levykrak/cwiartka/jpg/IMG_3934.JPG

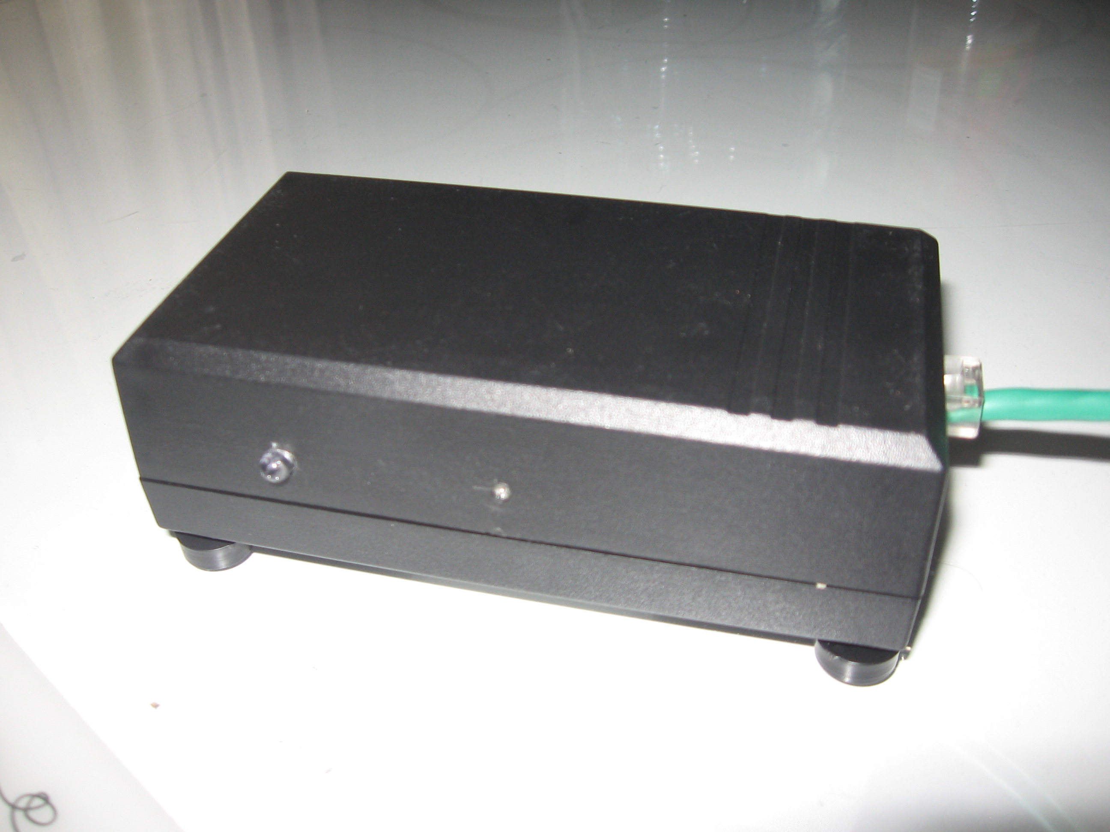
jpg/IMG_3934.JPG
