levykrak/cwiartka/jpg/IMG_3936.JPG

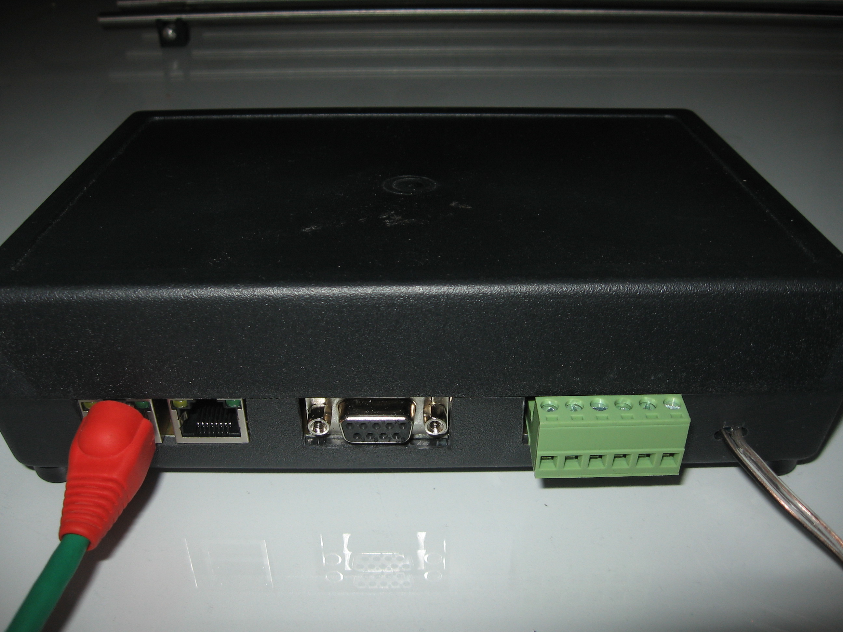
jpg/IMG_3936.JPG
