levykrak/cwiartka/rozne_pliki/25_08.pdf

# Projekty AVT

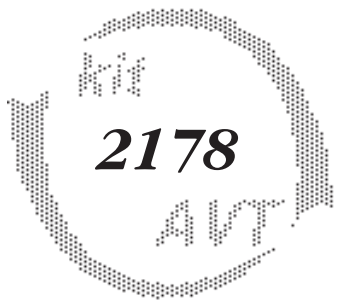
[picture p3: figure]
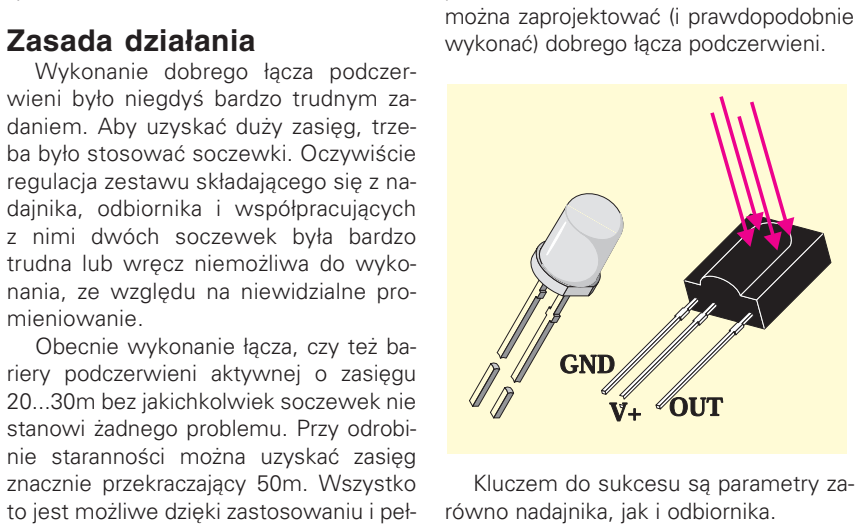
[picture p4: figure]
Zasada działania; Wykonanie dobrego łącza podczer− wieni było niegdyś bardzo trudnym za− daniem. Aby uzyskać duży zasięg, trze− ba było stosować soczewki. Oczywiście; dajnika, odbiornika i współpracujących z nimi dwóch soczewek była bardzo trudna lub wręcz niemożliwa do wyko− nania, ze względu na niewidzialne pro− mieniowanie. Obecnie wykonanie łącza, czy też ba− riery podczerwieni aktywnej o zasięgu 20...30m bez jakichkolwiek soczewek nie stanowi żadnego problemu. Przy odrobi− nie staranności można uzyskać zasięg znacznie przekraczający 50m. Wszystko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

ELEKTRONIKA DLA WSZYSTKICH 1/98 | 11

Nie słabnie zainteresowanie wszel− kiego typu urządzeniami wykorzystują− cymi promieniowanie podczerwone. W EdW przedstawiliśmy już kilka ukła− dów wykorzystujących podczerwień, a listy Czytelników przynaglają nas do przedstawienia kolejnych.
W niniejszym artykule przedstawio− no układ toru podczerwieni dalekiego zasięgu, umożliwiający stworzenie ba− riery o zasięgu 50m i większym. Uwa− ga! Tak duży zasięg uzyskano bez ja− kichkolwiek soczewek czy innych ukła− dów optycznych. Co ciekawe, suma− ryczny pobór prądu przez nadajnik i od− biornik wynosi mniej niż 10mA, z cze− go ponad 90% pobiera nadajnik. Artykuł pokazuje, w jaki sposób można uzyskać bardzo duży zasięg przy minimal− nym poborze prądu. Zawarte w nim wia− domości będą wielką pomocą dla osób chcących samodzielnie zaprojektować podobny układ według własnych potrzeb. Przedstawiany układ przeznaczony jest głównie do celów eksperymental− nych, ale może także znaleźć praktyczne zastosowania. Każdy, kto interesuje się wykorzystaniem promieniowania pod− czerwonego, powinien wykonać oraz praktycznie przebadać opisany dalej pros− ty i tani układ.

regulacja zestawu składającego się z na−

to jest możliwe dzięki zastosowaniu i peł− nym wykorzystaniu parametrów nowo− czesnych podzespołów.
W opisywanym układzie zastosowano dobrze znany scalony odbiornik podczer− wieni TFMS5360 oraz wysokosprawną diodę podczerwoną o wąskim kącie świe− cenia. Ich właściwe wykorzystanie umoż− liwia osiągnięcie wręcz rewelacyjnych pa− rametrów łącza. Jednocześnie każda nie− doróbka mści się dotkliwie i znacznie zmniejsza zasięg. Ponieważ chodzi o „wyduszenie” ze wspomnianych pod− zespołów wszystkich ich możliwości, ko− nieczne jest zapoznanie się z głównymi parametrami. Bez ich zrozumienia nie

W przypadku diody nadawczej podsta− wowe znaczenie mają dwie sprawy:
– kąt świecenia diody
– maksymalny dopuszczalny prąd impul− sowy.
W przypadku odbiornika podstawowe znaczenie ma częstotliwość impulsów oraz długość fali świetlnej.
W tabeli 1 podano podstawowe para−
metry | diod | nadawczych | TSIP5201

# Prosty tor osty tor podczerwieni aktywnej podczerwieni aktywnej dalekiego zasięgu dalekiego zasięgu

Podstawowe parametry diod TSIP520X: Dopuszczalne
napięcie wsteczne: | 7 V
Prąd przewodzenia: | 150 mA
Szczytowy prąd przewodzenia
(tp /T=0,5, tp =100µs): 300 mA Niepowtarzalny prąd przewodzenia
(tp =100µs): | 3 A
Moc strat: | 210 mW
Maksymalna
temperatura złącza: | 100°C
Rezystancja
termiczna Rthja: | 350 K/W
Kąt świecenia: | ±17 stopni
Długość fali
promieniowania: | 925 nm
Czas włączania
i wyłączania: | 500...800 ns
Natężenie promieniowania
(IF =100mA, tp =20ms):
TSIP5200: | 40 mW/sr
TSIP5201: | 50 mW/sr

Tabela 1

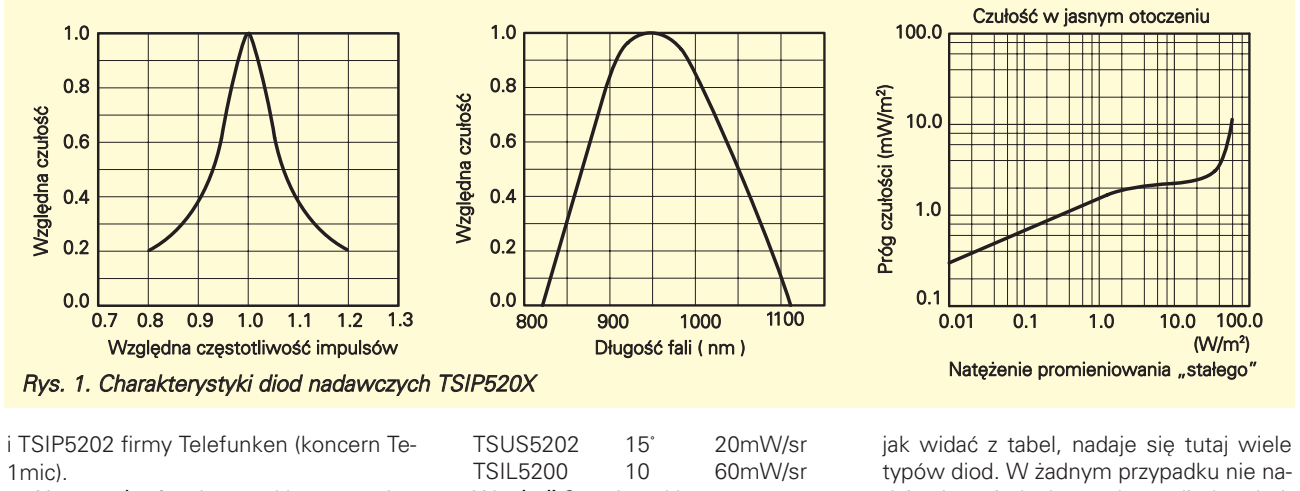
[picture p5: figure]
1mic).; TSUS5202; TSIL5200; typów diod. W żadnym przypadku nie na−

### 12 ELEKTRONIKA DLA WSZYSTKICH 1/98

i TSIP5202 firmy Telefunken (koncern Te−

Na rysunku 1 pokazano kluczowe cha− rakterystyki tych diod. Rysunek 1a poka− zuje charakterystykę promieniowania. Jak widać, światło emitowane jest w po− staci stosunkowo wąskiego stożka. Dzię− ki zmniejszeniu kąta stożka promieniowa− nia uzyskuje się kilku−, a nawet kilkuna− stokrotne zwiększenie natężenia promie− niowania w porównaniu z „klasycznymi” diodami, o kącie świecenia ±25...±40 . Bardzo ważne informacje zawiera rysu− nek 1b. Pokazuje on, że przy zastosowa− niu impulsowej pracy diody, możliwa jest praca przy prądach znacznie większych niż nominalny prąd przewodzenia (który zwyk− le wynosi 100...150mA). Przykładowo przy współczynniku wypełnienia tp/T = 0,01 i czasie impulsu 0,1 milisekundy, wartość prądu podczas impulsu może wynieść 2A! W prezentowanym układzie współczynnik wypełnienia jest jeszcze mniejszy, a czas impulsu – krótszy, można więc pracować przy prądzie o wartości 3A! Nikomu chyba nie trzeba tłumaczyć, że ze wzrostem prą− du rośnie także natężenie promieniowa− nia, a tym samym zasięg łącza. Przykłado− wo w katalogach zazwyczaj podaje się na− tężenie przy prądzie 100mA. Omawiane diody przy prądzie przewodzenia równym 1.5A i czasie impulsu równym 100µs za− pewniają natężenie promieniowania:
TSIP5200: | 240...520 mW/sr
TSIP5201: | 360...650 mW/sr
Rysunek 1c pokazuje zależność napię− cia i prądu przewodzenia – jak widać, przy prądzie 3A spadek napięcia na diodzie wyniesie około 2,5V. Jest to potrzebne do oszacowania wartości rezystora sze− regowego ograniczającego prąd diody. Rysunek 1 pokazuje charakterystyki diod TSIP520X. W ofercie firmy Telefun− ken (Temic) można znaleźć kilka innych diod o zbliżonych parametrach, które również można stosować w opisywanym urządzeniu:
TSUS5200 | 15° | 20mW/sr
(przy 100mA)
TSUS5201 | 15° | 20mW/sr

W tabeli 2 podano kluczowe paramet− ry kilku diod produkowanych przez firmę Siemens.
Również tu najważniejszym paramet− rem jest natężenie promieniowania, wy− rażone w miliwatach na steradian (mW/sr). Warto zauważyć, że duże natę− żenie promieniowania uzyskuje się tylko przy małych kątach świecenia – cała moc skoncentrowana jest wówczas w małym stożku promieniowania. Dla porównania w tabeli zamieszczono dane popularnej diody LD271, która ma znacznie większy kąt rozsyłu światła (±25 ), a tym samym małe natężenie (tylko 10mW/sr).Jak wi− dać z przedstawionych danych, zasięg łą− cza podczerwieni będzie zależeć głównie od kąta promieniowania diody (oraz szczytowej wartości prądu). Aby uzyskać zasięg kilkudziesięciu metrów, w opisy− wanym układzie koniecznie trzeba zasto− sować diodę o jak najwęższym kącie – jak widać z tabel, nadaje się tutaj wiele

dają się tu jednak popularne diody od pi− lotów zdalnego sterowania, ponieważ z reguły mają one szeroki kąt świecenia. Przy zastosowaniu takiej „zwykłej diody od pilota nie ma co liczyć na uzyskanie za− sięgu rzędu 50m.
Drugim kluczowym czynnikiem jest zastosowanie dobrego odbiornika. Aby maksymalnie uprościć konstrukcję zasto− sowano typowy scalony odbiornik pod− czerwieni TFMS5360. Czytelnicy EdW sporo już o tym układzie wiedzą. Układ TFMS5360 zawiera w sobie fotodiodę, wzmacniacz, filtr i inne obwody, dzięki którym nie reaguje na przypadkowe syg− nały podczerwieni, a tylko na przebiegi o określonej częstotliwości. Dwie środ− kowe cyfry oznaczenia podają tę częstot− liwość (w kilohercach) – układ TFMS5360 reaguje jedynie na impulsy promieniowa− nia podczerwonego o częstotliwości po− wtarzania 36kHz. Rysunek 2a pokazuje,

Rys. 1. Charakterystyki diod nadawczych TSIP520X

Typ | Kąt [°] | mW/sr | µs | nm | Obudowa
LD271L | 25 | 10,00 | 1,0 | 950 | 5−mm−LED
LD274 | 10 | 50,00 | 1,0 | 950 | 5−mm−LED
LD274−2 | 10 | 50,00 | 1,0 | 950 | 5−mm−LED
LD274−3 | 10 | 80,00 | 1,0 | 950 | 5−mm−LED
SFH400 | 6 | 20,00 | 1,0 | 950 | TO−18
SFH400−2 | 6 | 20,00 | 1,0 | 950 | TO−18
SFH400−3 | 6 | 32,00 | 1,0 | 950 | TO−18
SFH400−4 | 6 | 50,00 | 1,0 | 950 | TO−18
SFH401 | 15 | 16,00 | 1,0 | 950 | TO−18
SFH401−3 | 15 | 16,00 | 1,0 | 950 | TO−18
SFH401−4 | 15 | 25,00 | 1,0 | 950 | TO−18
SFH415 | 17 | 16,00 | 0,5 | 950 | 5−mm−LED
SFH415−T | 17 | 25,00 | 0,5 | 950 | 5−mm−LED
SFH415−U | 17 | 40,00 | 0,5 | 950 | 5−mm−LED
SFH416−R | 28 | 10,00 | 0,5 | 950 | 5−mm−LED
SFH480−2 | 6 | 40,00 | 0,6 | 880 | TO−18
SFH480−3 | 6 | 63,00 | 0,6 | 880 | TO−18
SFH481 | 15 | | “” | 880 | TO−18
SFH481−1 | 15 | 10,00 | 0,6 | 880 | TO−18
SFH481−2 | 15 | 16,00 | 0,6 | 880 | TO−18
SFH481−3 | 15 | 25,00 | 0,6 | 880 | TO−18
SFH484 | 8 | 50,00 | 0,6 | 880 | 5−mm−LED
SFH484−1 | 8 | 50,00 | 0,6 | 880 | 5−mm−LED

Tabela 2

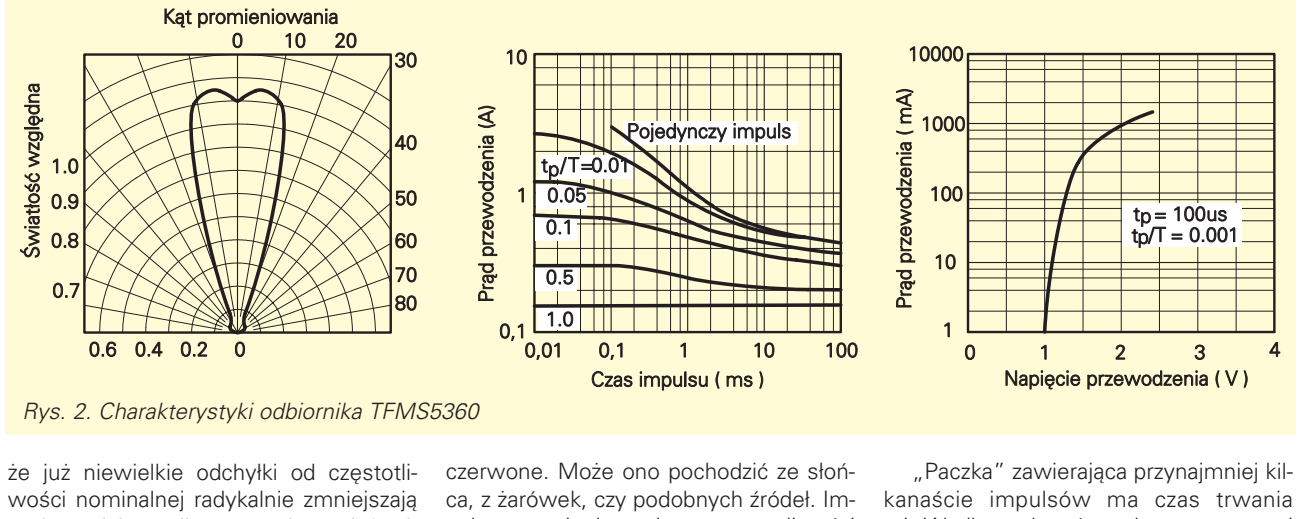
[picture p6: figure]
wości nominalnej radykalnie zmniejszają; czerwone. Może ono pochodzić ze słoń−; „Paczka” zawierająca przynajmniej kil− kanaście impulsów ma czas trwania; Rys. 2. Charakterystyki odbiornika TFMS5360

że już niewielkie odchyłki od częstotli−

czułość. Jak wynika z rysunku 2a już od− chyłka o 10% od częstotliwości środko− wej daje ponad dwukrotne zmniejszenie czułości. Do tego dochodzi jeszcze nie− unikniona tolerancja związana z rozrzuta− mi produkcyjnymi – należy liczyć się z od− chyłkami częstotliwości środkowej rzędu do 5%. Biorąc to pod uwagę, należy za− pewnić właściwą, stabilną częstotliwość impulsów wysyłanych z nadajnika. O czu− łości i stabilności parametrów decydo− wać więc będzie stabilność częstotliwoś− ci generatora impulsów 36kHz w nadajni− ku.
Drugą sprawą, którą należy wziąć pod uwagę jest długość fali promieniowania. Niektóre diody (np. LD274) promieniują

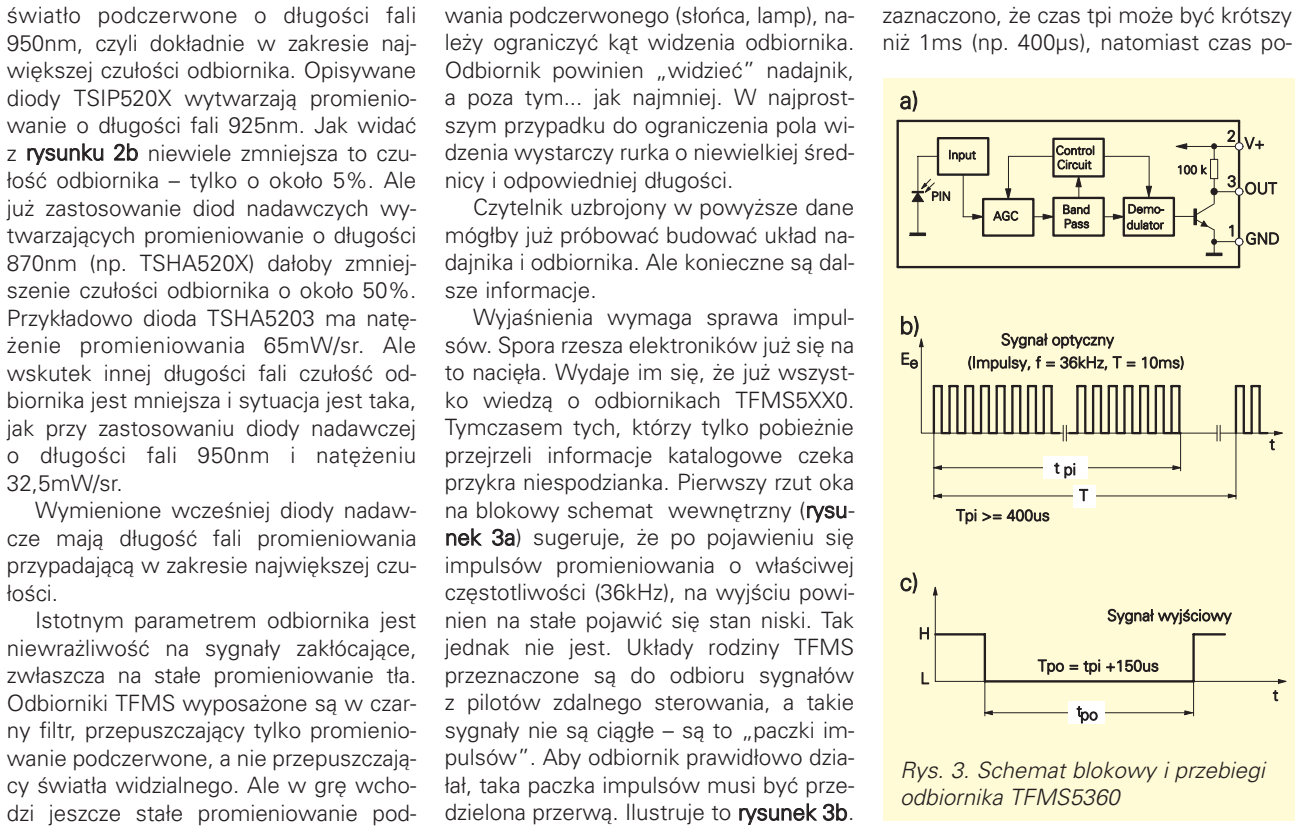
[picture p7: figure]
światło podczerwone o długości fali 950nm, czyli dokładnie w zakresie naj− większej czułości odbiornika. Opisywane diody TSIP520X wytwarzają promienio− wanie o długości fali 925nm. Jak widać z rysunku 2b niewiele zmniejsza to czu− łość odbiornika – tylko o około 5%. Ale już zastosowanie diod nadawczych wy− twarzających promieniowanie o długości 870nm (np. TSHA520X) dałoby zmniej− szenie czułości odbiornika o około 50%. Przykładowo dioda TSHA5203 ma natę− żenie promieniowania 65mW/sr. Ale wskutek innej długości fali czułość od−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

biornika jest mniejsza i sytuacja jest taka, ca, z żarówek, czy podobnych źródeł. Im− pulsy promieniowania o częstotliwości 36kHz są więc prawie zawsze nałożone na stałe promieniowanie tła. Rysunek 2c pokazuje, jak zmienia się czułość na im− pulsy w zależności od tego stałego pro− mieniowania tła. Jak widać czułość znacznie się zmniejsza przy wzroście te− go stałego promieniowania. Na rysunku 2 nie pokazano charakterystyki czułości kątowej (przestrzennej) odbiornika. Wy− starczy wiedzieć, że odbiornik „patrzy” bardzo szeroko, mniej więcej ±55 od osi (obszar największej czułości zaznaczony jest fioletowymi strzałkami na rysunku wstępnym).
Jeśli tak, to aby zapobiec utracie czu− łości pod wpływem „obcego” promienio−

dzenia wystarczy rurka o niewielkiej śred−

dajnika i odbiornika. Ale konieczne są dal−

sów. Spora rzesza elektroników już się na to nacięła. Wydaje im się, że już wszyst−

nien na stałe pojawić się stan niski. Tak

sygnały nie są ciągłe – są to „paczki im−

łał, taka paczka impulsów musi być prze− dzielona przerwą. Ilustruje to rysunek 3b.

tpi. Według zaleceń producenta czas tpi nie powinien być krótszy niż 400µs. Bio− rąc pod uwagę, że impulsy o częstotli− wości 36kHz mają okres równy 27,7µs, w każdej paczce nie powinno być mniej niż 15 impulsów. Jeśli będzie ich mniej, to układ może nieprawidłowo reagować na pobudzenie. A jeśli będzie ich więcej? To akurat nic nie przeszkadza, pod warun− kiem, że czas trwania paczki impulsów tpi jest krótszy od czasu przerwy. Ściślej biorąc, dla prawidłowej pracy odbiornika czas powtarzania, oznaczony na rysunku 3b literą T, powinien być przynajmniej 2,5 raza dłuższy niż czas tpi.
W praktyce czas przerwy może być, i często jest, bardzo długi. Na rysunku 3b zaznaczono, że czas tpi może być krótszy
ELEKTRONIKA DLA WSZYSTKICH 1/98 | 13

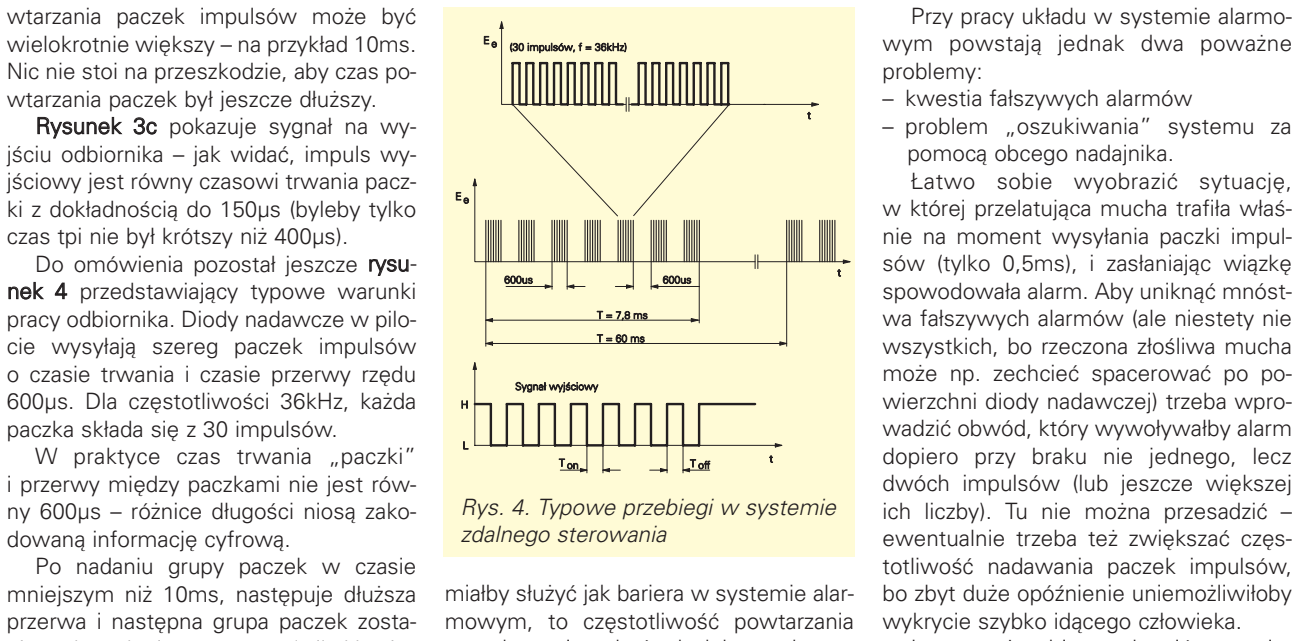
[picture p8: figure]
wtarzania paczek impulsów może być; wtarzania paczek był jeszcze dłuższy. Rysunek 3c pokazuje sygnał na wy−; czas tpi nie był krótszy niż 400µs). Do omówienia pozostał jeszcze rysu− nek 4 przedstawiający typowe warunki; cie wysyłają szereg paczek impulsów o czasie trwania i czasie przerwy rzędu 600µs. Dla częstotliwości 36kHz, każda paczka składa się z 30 impulsów. W praktyce czas trwania „paczki” i przerwy między paczkami nie jest rów− ny 600µs – różnice długości niosą zako− dowaną informację cyfrową. Po nadaniu grupy paczek w czasie mniejszym niż 10ms, następuje dłuższa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

wielokrotnie większy – na przykład 10ms. Nic nie stoi na przeszkodzie, aby czas po−

jściu odbiornika – jak widać, impuls wy− jściowy jest równy czasowi trwania pacz− ki z dokładnością do 150µs (byleby tylko

pracy odbiornika. Diody nadawcze w pilo−

przerwa i następna grupa paczek zosta− nie nadana dopiero po 60ms (o ile klawisz w pilocie jest ciągle naciśnięty).
Tak mniej więcej pracuje pilot, a na wyjściu odbiornika TFMS występuje przebieg podobny, jak pokazano na dole rysunku 4. Czasy Ton i Toff odpowiadają czasowi trwania paczki impulsów oraz przerwy między paczkami.
Tak pracuje typowy system zdalnego sterowania z pilotem.
Natomiast opisywany tor podczerwie− ni pracuje w trochę innym rytmie. Tu rów− nież nadajnik wysyła paczki impulsów za− wierające około 18 impulsów o częstotli− wości 36kHz (co daje czas trwania paczki równą 500µs). Tym razem czas powtarza−

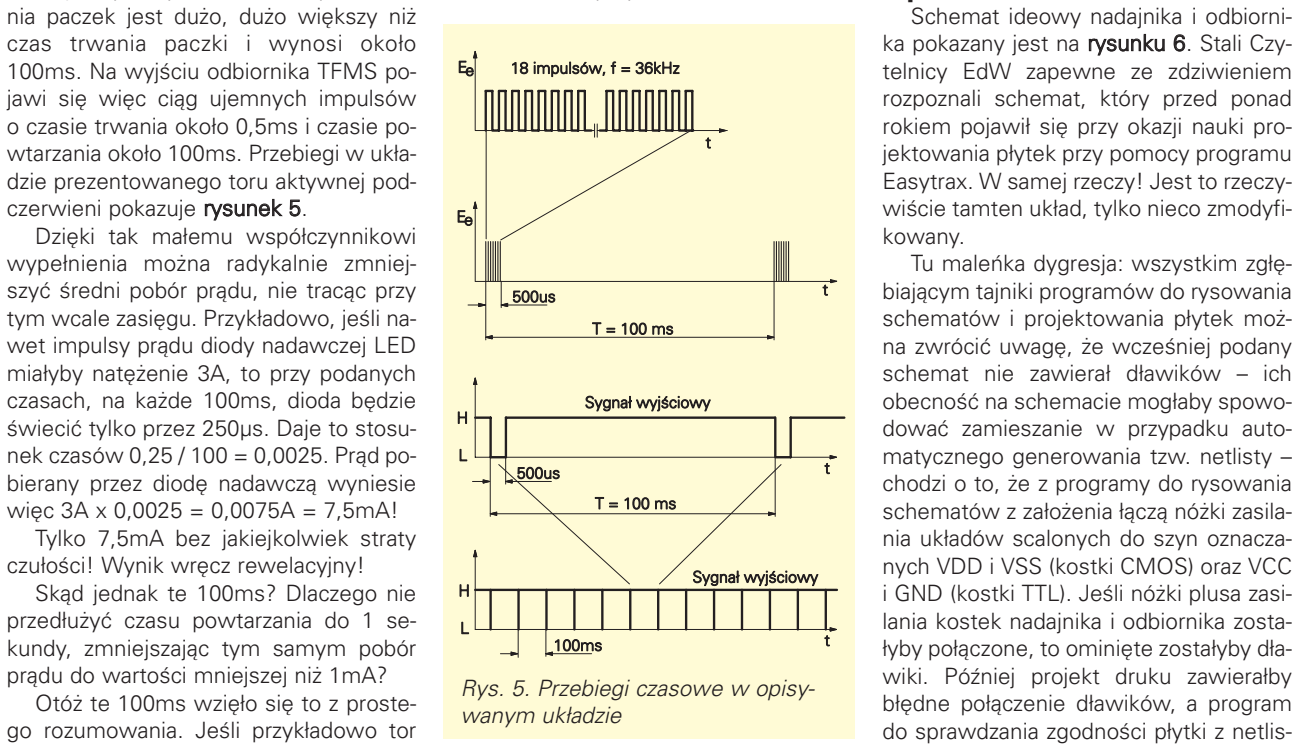
[picture p9: figure]
czas trwania paczki i wynosi około 100ms. Na wyjściu odbiornika TFMS po− jawi się więc ciąg ujemnych impulsów; dzie prezentowanego toru aktywnej pod− czerwieni pokazuje rysunek 5. Dzięki tak małemu współczynnikowi wypełnienia można radykalnie zmniej−; wet impulsy prądu diody nadawczej LED miałyby natężenie 3A, to przy podanych czasach, na każde 100ms, dioda będzie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

nia paczek jest dużo, dużo większy niż

o czasie trwania około 0,5ms i czasie po− wtarzania około 100ms. Przebiegi w ukła−

szyć średni pobór prądu, nie tracąc przy tym wcale zasięgu. Przykładowo, jeśli na−

świecić tylko przez 250µs. Daje to stosu− nek czasów 0,25 / 100 = 0,0025. Prąd po− miałby służyć jak bariera w systemie alar−

paczek powinna być tak dobrana, by na− wet szybko idący człowiek przeciął ją na czas w którym pojawi się przynajmniej dwie paczki. Te dwie paczki nie zostaną odebrane przez odbiornik i zostanie wy− wołany alarm. Jeśli czas miedzy kolejny− mi paczkami byłby zbyt długi, wtedy prze− chodzący człowiek po prostu nie zostałby zauważony – najprawdopodobniej prze− szedłby w przerwie między paczkami. Wartość 100ms wydaje się tu wystar− czająca – oczywiście w przypadku stoso− wania urządzenia w systemie alarmo− wym częstotliwość powtarzania paczek można zwiększyć z podanych 10Hz (100ms) do na przykład 25Hz (40ms).

w której przelatująca mucha trafiła właś−

Łatwo też sobie wyobrazić sytuację, w której przemyślny włamywacz unie− szkodliwi tor podczerwieni, świecąc za pomocą dowolnego pilota w odbiornik. Jeśli układ miałby kiedykolwiek praco− wać w systemie alarmowym, powinien zawierać obwody, które chroniłyby przed takim sabotażem i wywoływały alarm w przypadku wykrycia „obcej” sekwencji paczek impulsów. Sposobów realizacji obu wyżej podanych postula− tów jest mnóstwo. W prezentowanym układzie zrealizowano je w bardzo pros− ty sposób.

## Opis układu

ka pokazany jest na rysunku 6. Stali Czy−

rokiem pojawił się przy okazji nauki pro−

Easytrax. W samej rzeczy! Jest to rzeczy− wiście tamten układ, tylko nieco zmodyfi−

schematów z założenia łączą nóżki zasila−

i GND (kostki TTL). Jeśli nóżki plusa zasi− lania kostek nadajnika i odbiornika zosta− łyby połączone, to ominięte zostałyby dła−

do sprawdzania zgodności płytki z netlis−

### 14 ELEKTRONIKA DLA WSZYSTKICH 1/98

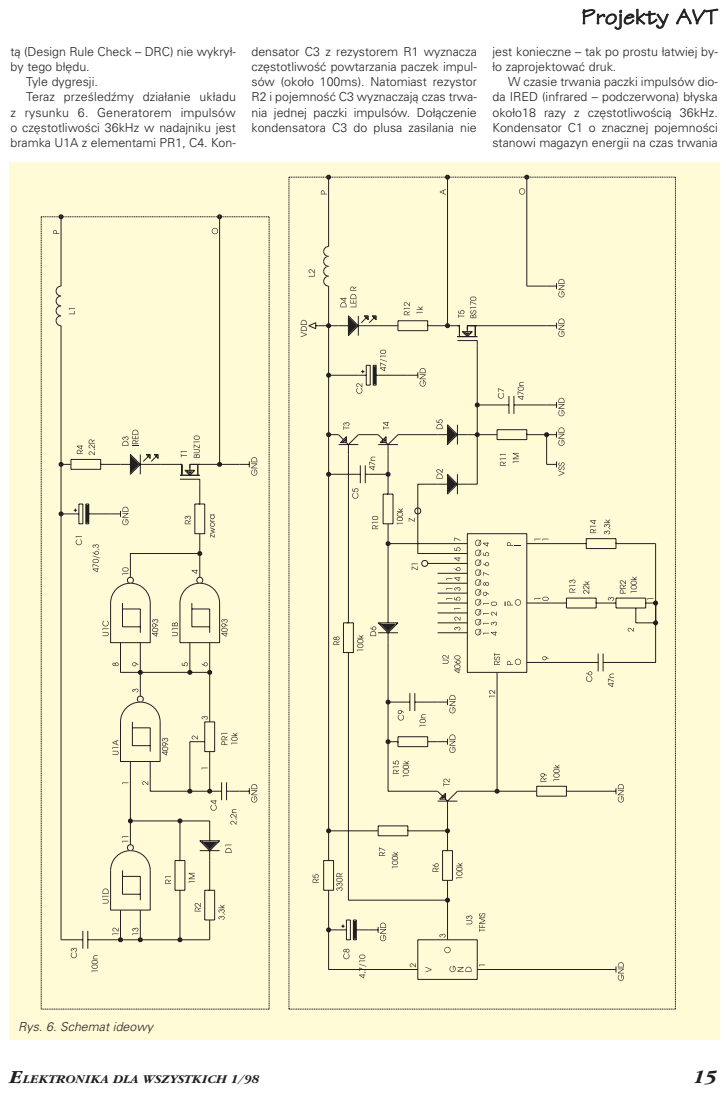
[picture p10: page 5]
ELEKTRONIKA DLA WSZYSTKICH 1/98

tą (Design Rule Check – DRC) nie wykrył−
by tego błędu.
Tyle dygresji.
Teraz prześledźmy działanie układu
z rysunku 6. Generatorem impulsów
o częstotliwości 36kHz w nadajniku jest
bramka U1A z elementami PR1, C4. Kon−

densator C3 z rezystorem R1 wyznacza
częstotliwość powtarzania paczek impul−
sów (około 100ms). Natomiast rezystor
R2 i pojemność C3 wyznaczają czas trwa−
nia jednej paczki impulsów. Dołączenie
kondensatora C3 do plusa zasilania nie

jest konieczne – tak po prostu łatwiej by−
ło zaprojektować druk.
W czasie trwania paczki impulsów dio−
da IRED (infrared – podczerwona) błyska
około18 razy z częstotliwością 36kHz.
Kondensator C1 o znacznej pojemności
stanowi magazyn energii na czas trwania

Rys. 6. Schemat ideowy

### 16 ELEKTRONIKA DLA WSZYSTKICH 1/98

paczki impulsów. Rezystor R4 o bardzo małej wartości pozwala w czasie trwania impulsu na przepływ prądu o dużej war− tości (przy napięciu zasilania 9V około 3A). Właśnie ze względu na tak dużą war− tość prądu zastosowano tranzystor mocy MOSFET. Małe MOSFETy takie jak BS107 czy BS170 maja rezystancję w stanie otwarcia rzędu kilku omów lub więcej i nie nadają się do tego zastoso− wania. W obwodzie bramki tranzystora T1 przewidziano rezystor R3. Przy wyko− rzystaniu tranzystora MOSFET jest on za− stąpiony zworą, ale w roli T1 może też pracować „darlington” npn większej mo− cy i wtedy rezystor będzie potrzebny do ograniczenia prądu bazy. W przypadku stosowania „darlingtona” należy się upewnić, czy jest on dostatecznie szybki. Dużą ostrożność trzeba wykazać przy próbie zastosowania w roli T1 zwykłego tranzystora npn. Przy jego niewielkim wzmocnieniu może się okazać, że bram− ki U1C i U1D nie są w stanie dostarczyć odpowiedniego prądu bazy. W każdym przypadku stosowania tranzystorów in− nych niż MOSFET, należy sprawdzić os− cyloskopem przebieg na kolektorze tran− zystora (na katodzie diody D3).

Przy tak dużych impulsach prądu ko− nieczne są obwody filtrujące – dławiki L1 i L2 oraz kondensatory C1 i C2. Czułość układu odbiorczego jest bardzo duża i bez dławików niemożliwe byłoby zasilanie na− dajnika i odbiornika z tego samego źród− ła, bo impulsy przechodzące z nadajnika do odbiornika przez linie zasilania zakłóca− łyby pracę układu U3.
Układ odbiornika wygląda dość zawile. Jego działanie nie jest jednak trudne do zrozumienia.
Pomocą w analizie będą rysun− ki 7 oraz 8.
Przede wszystkim trzeba wiedzieć, że w prawidłowo działającym torze, każda odebrana paczka impulsów wytwarza na wyjściu kostki TFMS krótki impuls ujem− ny (0,5ms), który z kolei powoduje wyze− rowanie licznika U1 (CMOS 4060). Od tej chwili określenie „impuls” będzie ozna− czać ten właśnie impuls elektryczny o dł− ugości 0,5ms, który pojawia się na wy− jściu odbiornika U3 (TFMS5360) po ode− braniu paczki impulsów świetlnych.
Po każdym takim impulsie licznik U2 zaczyna swą pracę od nowa. Na rysun− ku 7 pokazano niektóre przebiegi na jego wyjściach. Bardzo ważną rolę pełni syg− nał z wyjścia Q4 (nóżka 7 układu U2) – przebieg z rysunku 7b.
Na rysunku 7 pokazano, że licznik U2 rozpoczął cykl pracy po kolejnym impul− sie zerującym. Moment przyjścia tego impulsu zerującego zaznaczono pionową niebieską linią. Przebieg na wyjściu Q4 decyduje, co stanie się po przyjściu na− stępnego impulsu. Jeśli następny impuls z odbiornika TFMS pojawi się w czasie, gdy na wyjściu Q4 wystąpi stan wysoki (zaznaczono to zielonym kolorem na prze− biegu 7b), wtedy licznik zostanie prawid− łowo wyzerowany i cykl pracy rozpocznie się od nowa. Zerowanie licznika umożliwi podanie stanu wysokiego przez diodę D6 na kondensator C9 – dopiero wtedy tran− zystor T2 będzie mógł pewnie wyzero− wać kostkę przez jej wejście RST (nóżka 12). Obwód D6, R15 i C9 jest potrzebny do przedłużenia czasu trwania stanu wy− sokiego z wyjścia Q4. Należy pamiętać, że w chwili zerowania, na wyjściu Q4 po− jawia się stan niski. Bez obwodu D6, R15 i C9 impuls zerujący na wejściu RST był− by więc bardzo krótki (kilkadziesiąt nano− sekund), co w pewnych warunkach unie− możliwiłoby pełne zerowanie wszystkich stopni licznika. Wspomniany obwód po− zwala przedłużyć impuls zerujący kostkę U2 i pewnie ją wyzerować.
Wskutek tego ustawicznego zerowa− nia, w czasie normalnej pracy, przebieg na wyjściu Q4 będzie wyglądał jak na dol− nym rysunku – 7d, gdzie zaznaczono go kolorem zielonym. W tym miejscu należy zauważyć, że w czasie normalnej pracy, przebieg na wyjściu Q4 będzie miał wy− pełnienie różne od 50%. Częstotliwość oscylatora kostki U2 należy ustawić za pomocą potencjometru PR2 w ten spo− sób, by w czasie normalnej pracy dodat− nie impulsy występujące na wyjściu Q4 były dwukrotnie krótsze od czasu prze− rwy. Jak wynika z rysunku 7b, czas prze− rwy na wyjściu Q4 powinien trwać 66,6ms, co zostanie spełnione, jeśli okres drgań oscylatora będzie ustawiony za po− mocą PR2 na 133,2ms / 16 = 8,325ms, co odpowiada częstotliwości 120Hz. Przy takiej częstotliwości oscylatora uzyska się optymalny przebieg na wyjściu Q4. Z rysunku 7b jasno wynika, że zapewni to
znaczny | margines | bezpieczeństwa
w przypadku, gdyby częstotliwość gene− ratora taktującego w nadajniku (o okresie 100ms) zmieniła się o kilka czy kilkana− ście procent.
Właśnie, żeby uzyskać optymalny margines bezpieczeństwa, trzeba tak ustawić potencjometr PR2, aby następny impuls zerujący przychodził dokładnie tak jak pokazano na rysunku 7b. Wtedy właś− nie na wyjściu Q4 uzyska się przebieg o wypełnieniu 1/3, jak pokazuje to rysu− nek 7d. Rys. 7. Przebiegi czasowe w wersji podstawowej odbiornika

ELEKTRONIKA DLA WSZYSTKICH 1/98 | 17

Aby zabezpieczyć układ przed „obcy− mi” impulsami o innej częstotliwości po− wtarzania, dodano układy wywołujące alarm w przypadku, gdy następny impuls zerujący przyjdzie za wcześnie lub za póź− no. Jeśli następny impuls z odbiornika U3 pojawi się za wcześnie, to znaczy jeszcze podczas trwania stanu niskiego na wy− jściu Q4 (zaznaczonym czerwono na ry− sunku 7b), wtedy alarm zostanie wywoła− ny przez przewodzące tranzystory T3 i T4. Spowoduje to naładowanie konden− satora C7, otwarcie tranzystora T5 i za− świecenie czerwonej diody LED D4. Jeśli z kolei impuls zerujący nie przy− jdzie do czasu pojawienia się stanu wyso− kiego na wyjściu Q5 (porównaj rysunek 7c), wtedy alarm zostanie wywołany przez wyjście Q5 i diodę D2.
Jak z tego widać w stanie alarmu prze− wodzi tranzystor T5 (co można wykorzys− tać do współpracy z innymi urządzeniami) i świeci dioda D5 (co znakomicie przyda− je się podczas prób i regulacji).
Gdy wszystko jest w porządku, tran− zystor T5 jest zatkany. Układ pobiera nie− wielki prąd rzędu 1mA.
W tym miejscu parę słów na temat za− silania.
Ze względu na obecność układu TFMS, odbiornik musi być zasilany napię− ciem w zakresie 4,5...6V!
Natomiast nadajnik może być również zasilany napięciem rzędu 5...6V, jednak został przewidziany do zasilania napię− ciem 9V (dopuszczalne jest zasilanie na− pięciem 12V, co zwiększy prąd impulsów diody LED nieco powyżej katalogowych wartości).
Taki sposób zasilania wybrano, ponie− waż układ przeznaczony jest przede wszystkim do prób i eksperymentów, a mniej do praktycznych zastosowań. Jeśli ktoś będzie chciał uzyskać zasięg rzędu kilkudziesięciu metrów, i tak zasto− suje oddzielne źródło zasilania nadajnika, choćby w postaci bateryjki 9−woltowej lub akumulatorka 12V, w miejsce długie− go kabla.
Dlaczego układ nie jest zalecany do pracy w systemach alarmowych na wol− nym powietrzu?
Należy wziąć pod uwagę, że w tak prostym i tanim układzie nie uda się uzys− kać parametrów gwarantujących nieza− wodną pracę w każdych warunkach. Cho− dzi tu głównie o zmiany temperatury i na− pięcia zasilania nadajnika. Proste układy generatorów z bramkami U1D i U1A mo− gą nie zapewnić wystarczającej stabilnoś− ci przy zmianach temperatury otoczenia od −20...+30 C, a przynajmniej na takie temperatury narażony jest układ pracują− cy na wolnym powietrzu. Ponadto częs− totliwość wspomnianych generatorów znacznie zależy od napięcia zasilającego i dla długotrwałej niezawodnej pracy nale− ży stosować stabilizację napięcia zasilają− cego nadajnik.
Nie umniejsza to w żadnym stopniu zalet prezentowanego układu. Z jego po− mocą można uzyskać naprawdę rewela− cyjny zasięg bariery.
Teraz kolejna sprawa.
Opisany powyżej sposób pracy wywo− ła alarm już przy braku jednego jedynego impulsu świetlnego. Jak wspomniano, dla zapobieżenia fałszywym alarmom, wywoływanym choćby przez przelatują− ce muchy, układ powinien wywoływać alarm dopiero przy braku nie jednego, tyl− ko dwóch impulsów świetlnych.
Można to zrealizować w bardzo prosty sposób, łącząc anodę diody D2 nie do wyjścia Q5, tylko Q6 (nóżka 4). W tym celu trzeba przeciąć istniejące połączenie i połączyć punkty oznaczone Z, Z1. Przebiegi w układzie będą wyglądać jak na rysunku 8. Tym razem, ponieważ dopuszczalne jest „zaginięcie” jednego impulsu, częstotliwość oscylatora kostki U2 należy ustawić nieco mniejszą, tak by czas przerwy wynosił 60ms (częstotli− wość oscylatora około 133Hz). Przy takim ustawieniu następny prawidłowy impuls, pojawiający się po kolejnych 100 milise− kundach wypadnie mniej więcej na po− czątku kolejnego impulsu na wyjściu Q4 – pokazuje to rysunek 8b.
Podobnie, jak poprzednio, jeśli impuls zerujący nie nadejdzie do czasu pojawie− nia się stanu wysokiego na wyjściu Q6, zostanie wywołany alarm (przez diodę D2).
Przy prawidłowej pracy tej wersji, na wyjściu Q4 powinny występować impul− sy o współczynniku wypełnienia, nie jak poprzednio 1/3 (33%), tylko 2/5 (40%). Oczywiście, można anodę diody D2 dołączyć do wyjścia Q7, i wtedy układ nie zareaguje nawet przy „zagubieniu” trzech kolejnych impulsów świetlnych. W takim wypadku trzeba jeszcze nieco zwiększyć częstotliwość oscylatora kost− ki U2, a podczas normalnej pracy prze− bieg na wyjściu Q4 będzie miał większe wypełnienie, zbliżone do 45%.
Jak widać z tego opisu, działanie ukła− du jest w sumie bardzo proste. Okazuje się jednak, że do uruchomienia i wyregu− lowania układu nie wystarczy miernik uni− wersalny, potrzebny będzie oscyloskop. Właśnie ze względu na konieczność sta− rannego wyregulowania, stopień trud− ności projektu oceniono na dwie gwiazd− ki.
W zasadzie, na podstawie podanych dalej wskazówek można wyregulować układ korzystając tylko z miernika (współ−

Rys. 8. Przebiegi czasowe w zmodyfikowanej wersji odbiornika czynnik wypełnienia impulsów można określić jako stosunek uśrednionego na− pięcia stałego do napięcia zasilającego, dołączając miernik przez obwód całkujący RC o dużej stałej czasowej). Jednak w przypadku jakichkolwiek kłopotów czy wątpliwości nie obędzie się bez pomocy oscyloskopu.

## Montaż i uruchomienie

Układ można zmontować na dwóch maleńkich płytkach drukowanych pokaza− nych na rysunku 9. Montaż nie sprawi większych kłopotów, a dodatkową pomo− cą będą fotografie modelu. Płytki zostały przewidziane do umieszczenia w odcin− kach rurki instalacyjnej o średnicy we− wnętrznej 23mm, używanej przez elekt− ryków.
Warto wcześniej przygotować te rurki i podczas montażu sprawdzać, czy układ zmieści się wewnątrz niej. Szczególną uwagę trzeba zwrócić na kondensator C1 w nadajniku, który prawdopodobnie trze− ba będzie zmontować poziomo. Odbior− nik TFMS można wlutować wprost w płytkę, ale w modelu nie obcinano jego nóżek, tylko wygięto je w łuk i przyluto− wano od strony druku.
Na początek, można nie montować w nadajniku rezystora R4, a zamiast nie− go wlutować rezystor o wartości 68...150Ω. Zabezpieczy to diodę nadaw− czą w przypadku błędów w działaniu na− dajnika.
Montaż nie sprawi kłopotów, nie ma tu nic szczególnie trudnego.
Po zmontowaniu nadajnika i odbiorni− ka całość trzeba wyregulować. Potencjometrem PR1 należy ustawić częstotliwość powtarzania impulsów równą 36kHz. Posiadacze zwykłych, prostych oscyloskopów mogą mieć kło−
poty | z | zaobserwowaniem | krótkich
„paczek impulsów” o częstotliwości 36kHz, trwających tylko około 500µs. Na czas ustawiania częstotliwości generato− ra U1A można zewrzeć wejścia bramki U1D do masy, ale lepiej jest w miejsce rezystora R2 o wartości 3,3kΩ, dać rezys− tor o wartości 220kΩ...1MΩ. Oczywiście do takich eksperymentów rezystor R4 musi mieć wartość rzędu co najmniej 100Ω, bo przy wartości 2,2Ω dioda na− dawcza w krótkim czasie ulegnie uszko− dzy granicami zanikania impulsów na wy− jściu U3. Znalezienie właściwej pozycji potencjometry PR1 będzie jeszcze łat− wiejsze, jeśli rezystor R4 zostanie jeszcze bardziej zwiększony – nawet do kilku kilo− omów. Czułość odbiornika jest bardzo du− ża i przy próbach na stole wystarczy bar− dzo mały prąd diody nadawczej. Pozwoli to dokładniej dostroić nadajnik do częs− totliwości filtru odbiornika TFMS.
Po ustawieniu właściwej częstotliwoś− ci generatora U1A, należy skontrolować z grubsza czas trwania „paczki impul− sów” (ustala ją rezystor R2) i przerwy między paczkami (odpowiada za nią R1). Trzeba obejrzeć przebieg na nóżkach 1 i 11 kostki U1. Jeśli czasy te różnią się nie więcej niż o 20...50% od wcześniej podanych 0,5ms i 100ms, nie trzeba ni− czego zmieniać. W tak prostym układzie, gdzie dużo zależy od wielkości histerezy bramki (Schmitta) U1D, nie można się spodziewać idealnej dokładności. Czas trwania paczki impulsów nie powinien być jednak krótszy niż 0,4ms. Jeśli bę− dzie dłuższy, to jedynie trochę wzrośnie pobór prądu. Odchyłki czasu powtarzania impulsów nie mają większego znaczenia, bo zostaną uwzględnione przy regulacji odbiornika.
Jeśli nadajnik pracuje poprawnie moż− na przystąpić do regulacji odbiornika. Przede wszystkim należy sprawdzić, czy na wyjściu układu U3 (nóżka 3) regularnie pojawiają się wąskie, szpilkowe ujemne impulsy, zgodnie z rysunkiem 5. Uwaga, impulsy te są bardzo wąskie, trzeba uważnie obserwować ekran oscylosko− pu, by ich nie przeoczyć.
Jeśli te impulsy występują regularnie, bez przerw i zakłóceń, należy podłączyć oscyloskop do wyjścia Q4 kostki U2 i po− tencjometrem PR2 ustawić właściwą częstotliwość oscylatora. To dla bardziej nerwowych elektroników może być najt− rudniejsza część uroczystości, bo w pier− wszej chwili trudno pojąć zależność kształtu przebiegu na ekranie od położe− nia suwaka
Dlatego trzeba się do tego zabrać sys− tematycznie. Na początek warto ustawić potencjometr PR2 na maksimum rezys− tancji. Wtedy najprawdopodobniej okres przebiegu będzie za duży i kolejne impul− sy zerujące będą przychodzić „za wcześ− rysunku 7b kolorem czerwonym. Nieste− ty, nie oznacza to, że na wyjściu Q4 bę− dzie trwał stan niski, albo wystąpią wąs− kie szpilki. Przy braku stanu wysokiego na wyjściu Q4 tranzystor T2 nie może pracować i licznik nie będzie zerowany. W efekcie na wyjściu Q4 pojawią się nie− zsynchronizowane przebiegi – po prostu śmieci.
Przy zmniejszaniu rezystancji poten− cjometru PR2, najpierw nie będzie dziać się nic szczególnie godnego uwagi – po prostu zmieniać się będzie rytm wystę− powania wspomnianych śmieci. Jednak w pewnym momencie czas impulsów zmniejszy się na tyle, że na wyjściu Q4 pojawi się regularny ciąg im− pulsów o częstotliwości wyznaczonej przez nadchodzące paczki impulsów op− tycznych. Układ „złapie synchronizację”. Na wyjściu Q4 pojawi się więc najpierw ciąg dodatnich wąskich szpilek, a przy zmniejszaniu rezystancji PR2, szpilki te zaczną się poszerzać. W końcu przy dal− szym zmniejszaniu wartości PR2, te do− datnie impulsy na wyjściu Q4 przybiorą kształt przebiegu prostokątnego o wypeł− nieniu 50%. Jeśli rezystancja PR2 zosta− nie zmniejszona jeszcze bardziej, to układ znów straci synchronizację i na wyjściu Q4 znów pojawią się śmieci.
Dla prawidłowej pracy w podstawo− wym układzie, należy tak ustawić PR2, by dodatnie impulsy na wyjściu Q4 miały wypełnienie 33%, czyli wyglądały tak, jak pokazuje rysunek 7d.
W pierwszym podejściu zaleca się przeprowadzić opisane regulacje w pod− stawowym układzie, to znaczy gdy anoda diody D2 jest dołączona do nóżki Q5. Jeśli ktoś chciałby dołączyć diodę D2 do wyjścia Q6 (by uzyskać niewrażliwość układu na brak jednego impulsu) powi− nien to zrobić dopiero po wyregulowaniu odbiornika w podstawowej wersji. Stroje− nie tej drugiej wersji jest podobne, ale łat− wiej jest najpierw w podstawowym ukła− dzie ustawić potencjometrem wypełnie− nie impulsów na Q4 równe 40%, a dopie− ro potem przeciąć ścieżkę i połączyć pun− kty Z – Z1.
Po takim wyregulowaniu na biurku, tor jest gotowy do testów „polowych”. Te− raz należy wlutować przepisany rezystor R4 o wartości 2,2Ω. Spowoduje to rady−

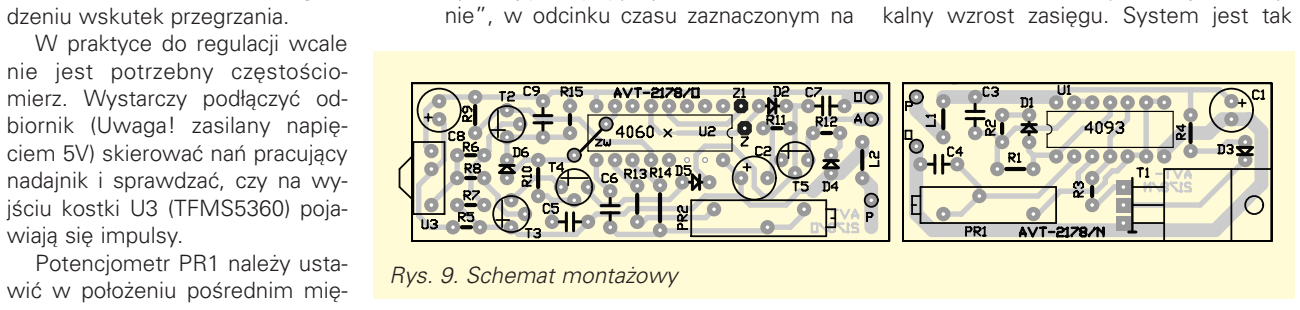
[picture p11: figure]
dzeniu wskutek przegrzania. W praktyce do regulacji wcale nie jest potrzebny częstościo− mierz. Wystarczy podłączyć od− biornik (Uwaga! zasilany napię− ciem 5V) skierować nań pracujący nadajnik i sprawdzać, czy na wy− jściu kostki U3 (TFMS5360) poja− wiają się impulsy. Potencjometr PR1 należy usta− wić w położeniu pośrednim mię−; nie”, w odcinku czasu zaznaczonym na; kalny wzrost zasięgu. System jest tak; Rys. 9. Schemat montażowy

### 18 ELEKTRONIKA DLA WSZYSTKICH 1/98

czuły, że podczas prób reaguje nie tylko na promieniowanie bezpośrednie, ale i te odbite od podłogi i ścian pomieszczenia. Właśnie ze względu na tak dużą czułość warto stosować wspomnianą rurkę ogra− niczającą kąt widzenia odbiornika (dobrze byłoby pomalować ją wewnątrz na cza− rno). Nadajnikiem nie trzeba się przejmo− wać, bo wiązka promieniowania diody D3 jest wąska sama z siebie. Przy testach modelu, dopiero zamknięcie odbiornika w szczelnej szufladzie powodowało alarm. Nawet niewielkie uchylenie szufla− dy powodowało reakcję odbiornika.
W czasie testów modelu pokazanego na fotografii osiągnięto zasięg około 50m w najprostszych warunkach, gdy nadajnik i odbiornik były trzymane w rękach przez dwie osoby, a nadajnik zasilany był napię− ciem 9V z małej bateryjki 6F22. Przy za− stosowaniu jak najwęziej świecących diod nadawczych i dobrym wycelowaniu nadajnika, zasięg ten powinien być jesz− cze większy.
Podczas testów należy zwrócić bacz− ną uwagę na stałość napięcia zasilające− go nadajnik. Nie wolno po wyregulowa− niu systemu potencjometrami PR1 i PR2 zmieniać napięcia zasilającego nadajnik, na przykład z 9 na 12V, bo spowoduje to niedopuszczalnie dużą zmianę częstotli− wości nadajnika oraz zmianę czasu po− wtarzania impulsów.
Tak duża moc nadawania i duża czu− łość odbiornika maja też w pewnych sy− tuacjach wady. Na przykład w pomiesz− czeniu nie uda się wykorzystać takiej ba− riery, bo nie będzie ona reagować na przerwanie wiązki! Dlaczego? To oczy− wiste. Światło odbite od przedmiotu przecinającego barierę, a potem wielo− krotnie odbite od ścian trafi w końcu do odbiornika. W takiej sytuacji trzeba oczy− wiście zmniejszyć moc nadajnika, zwięk− szając wartość rezystora R4, stosownie do długości bariery. W takim przypadku pobór prądu przez nadajnik zmniejszy się, nawet poniżej 1 miliampera, a bariera bę− dzie poprawnie funkcjonować. Jeśli za− sięg nie będzie przekraczać 10m, można też nadajnik zasilać napięciem 5V, tak samo jak odbiornik.
W każdym razie, prawidłowo wyregu− lowany układ umożliwia uzyskanie zaska− kująco dobrych efektów, dużego zasięgu i to przy bardzo małym poborze prądu. Materiał zawarty w niniejszym artyku− le ma zachęcić wszystkich praktykują− cych elektroników do samodzielnych prób w tej dziedzinie. Mile widziane są listy opisujące parametry uzyskane w za− prezentowanym układzie, a także donie− sienia o samodzielnych próbach. Listy ta− kie koniecznie należy opatrzyć dopiskiem „IRED”.
A w Elektronice dla Wszystkich za ja− kiś czas przedstawione zostaną kolejne układy wykorzystujące promieniowanie podczerwone.
Piotr Górecki
Zbigniew Orłowski
ELEKTRONIKA DLA WSZYSTKICH 1/98 | 19

Wykaz elementów
Rezystory
R6−R10,R15: 100kΩ
R1,R11: 1MΩ
R2,R14: 3,3kΩ
R3: zwora
R4: 2,2Ω
R5: 330Ω
R12: 1kΩ
R13: 22kΩ
PR1: 10kΩ helitrim
PR2: 100kΩ helitrim
Kondensatory
C1: 470µF/6,3V
C2: 47µF/10V
C3: 100nF
C4: 2,2nF
C5,C6: 47nF
C7: 470nF
C8: 4,7µF/10V
C9: 10nF
Półprzewodniki
D1,D2,D5,D6: 4148
D3: LD274 lub
D4: LED R
T1: BUZ10
T2,T3,T4: BC558B
T5: BS170
U1: 4093
U2: 4060
U3: TFMS5360
Pozostałe
L1,L2: 100µH dławik
