levykrak/cwiartka/brama.jpg

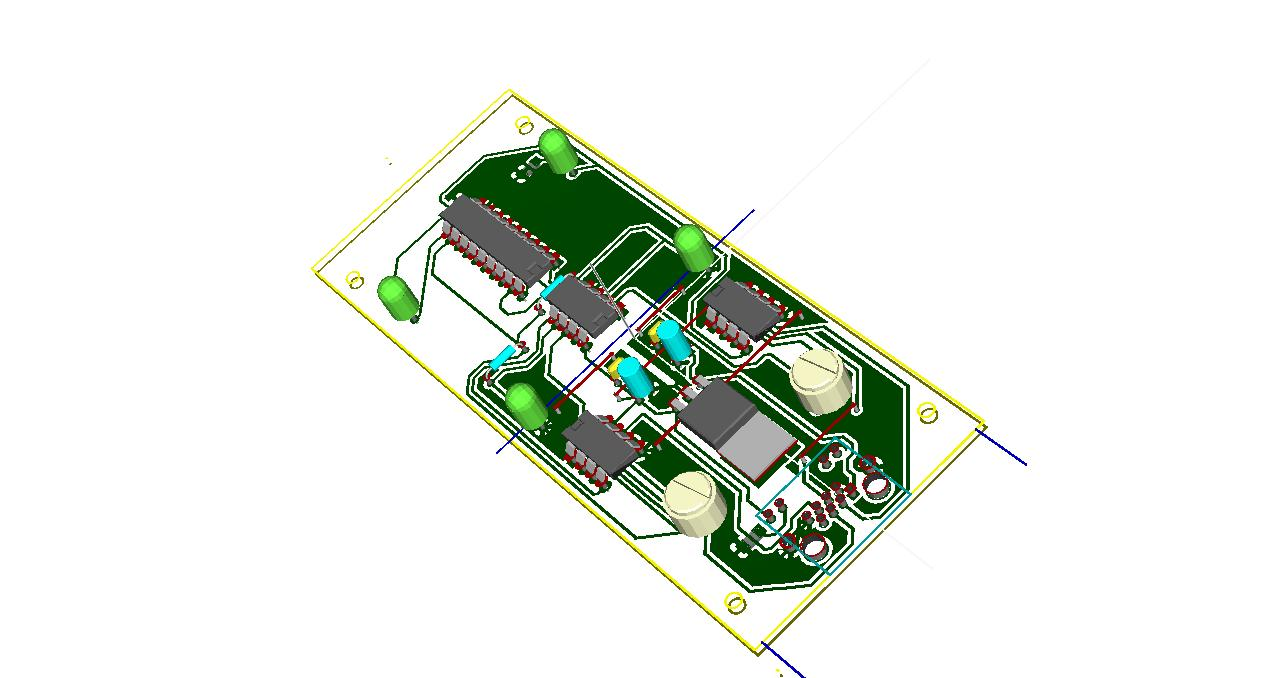
brama.jpg
