levykrak/cwiartka/front.jpg

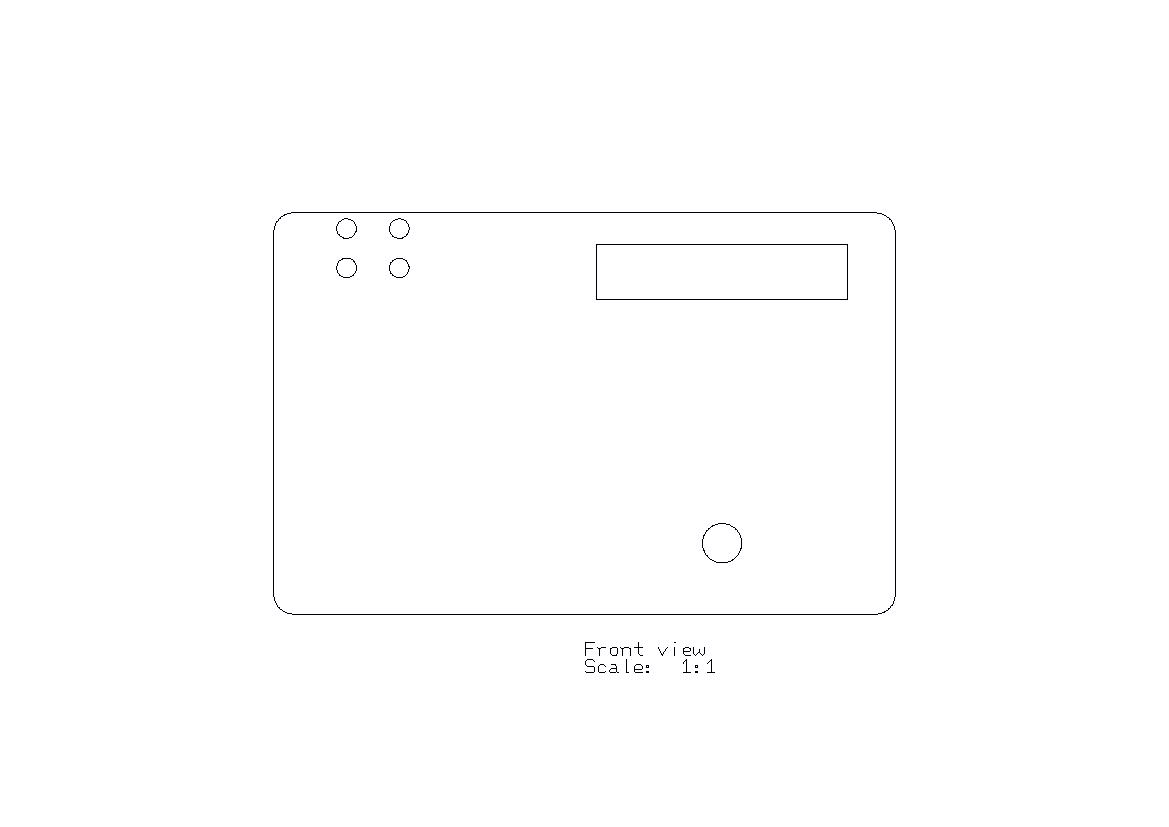
front.jpg
