levykrak/cwiartka/generator/attiny-schematic.png

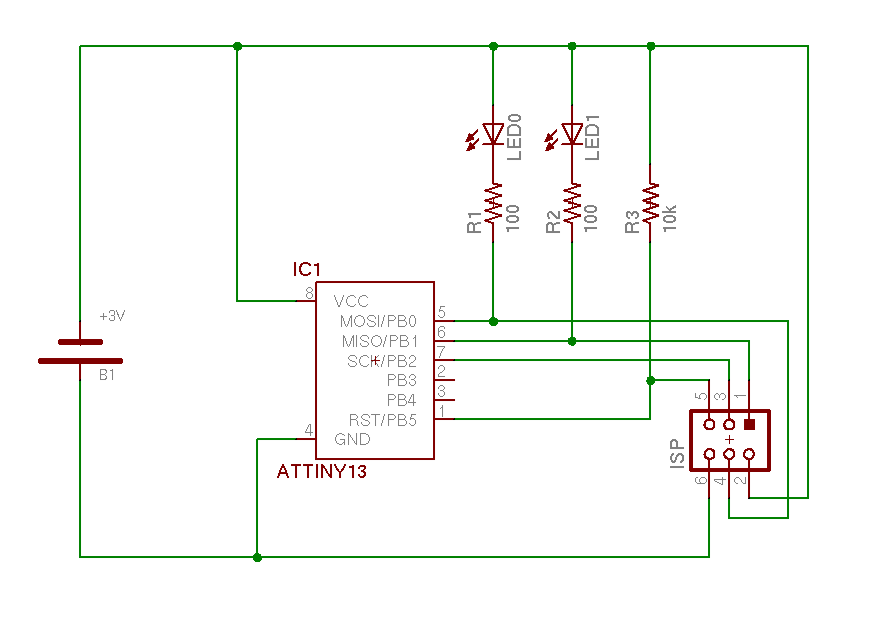
generator/attiny-schematic.png
