levykrak/cwiartka/jpg/IMG_3935.JPG

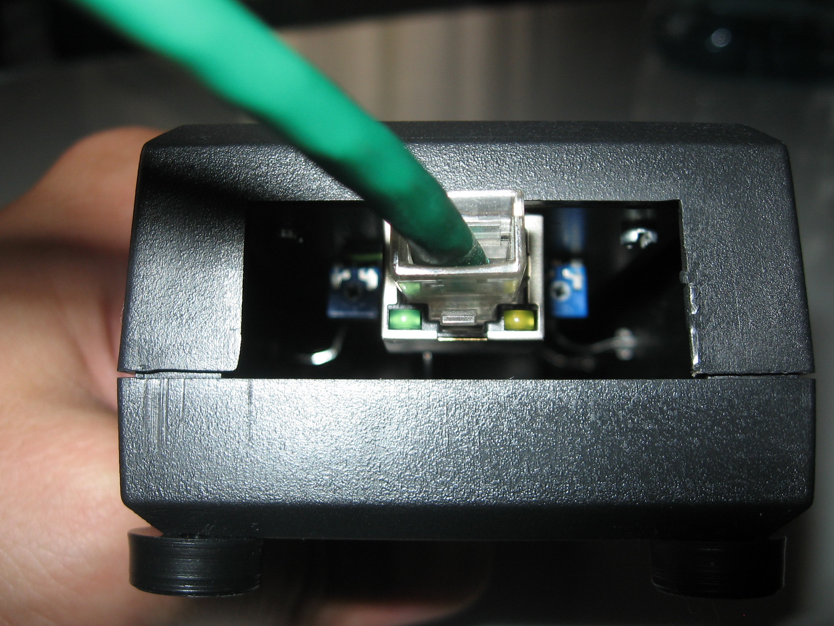
jpg/IMG_3935.JPG
