levykrak/cwiartka/jpg/IMG_3937.JPG

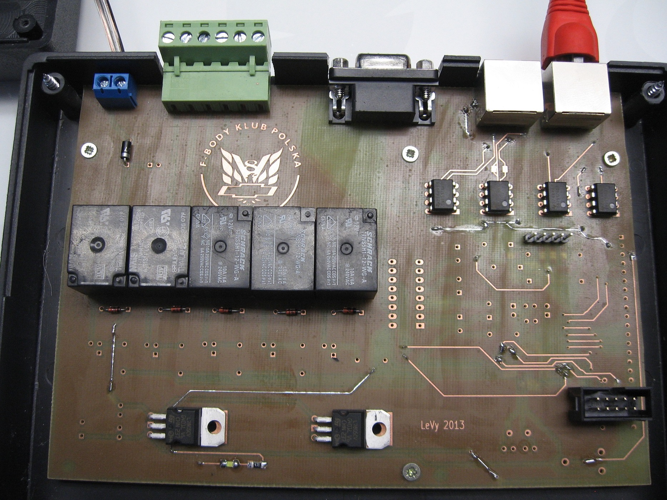
jpg/IMG_3937.JPG
