levykrak/cwiartka/jpg/IMG_3938.JPG

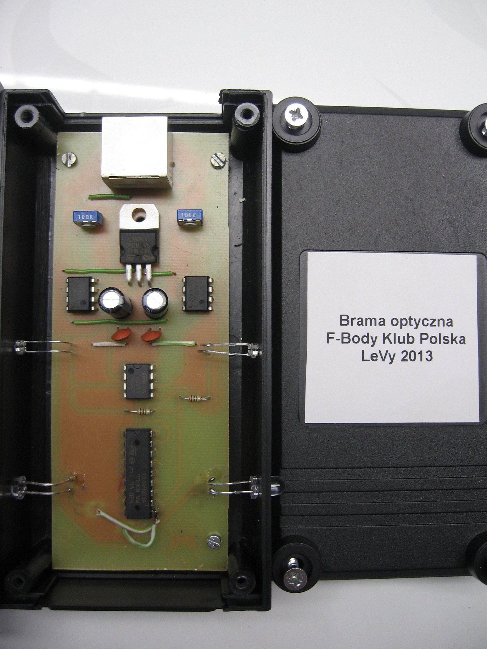
jpg/IMG_3938.JPG
