levykrak/cwiartka/kicad/render.jpg

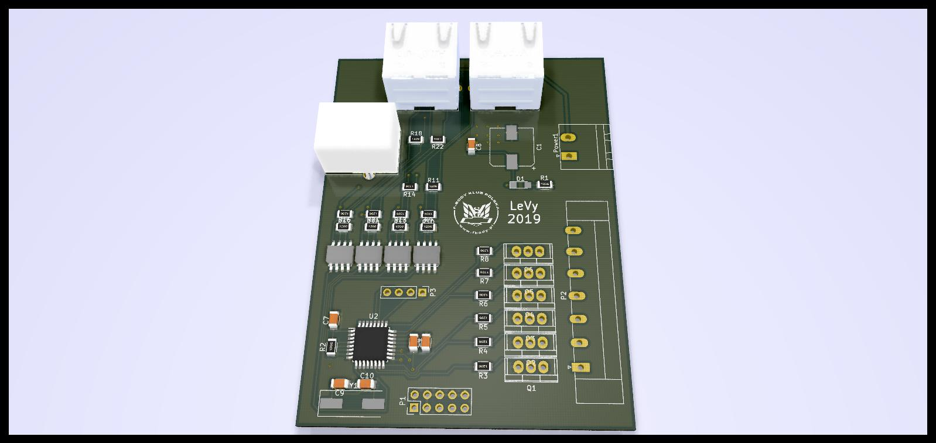
kicad/render.jpg
