levykrak/cwiartka/kicad_backup/plyta_glowna.jpg

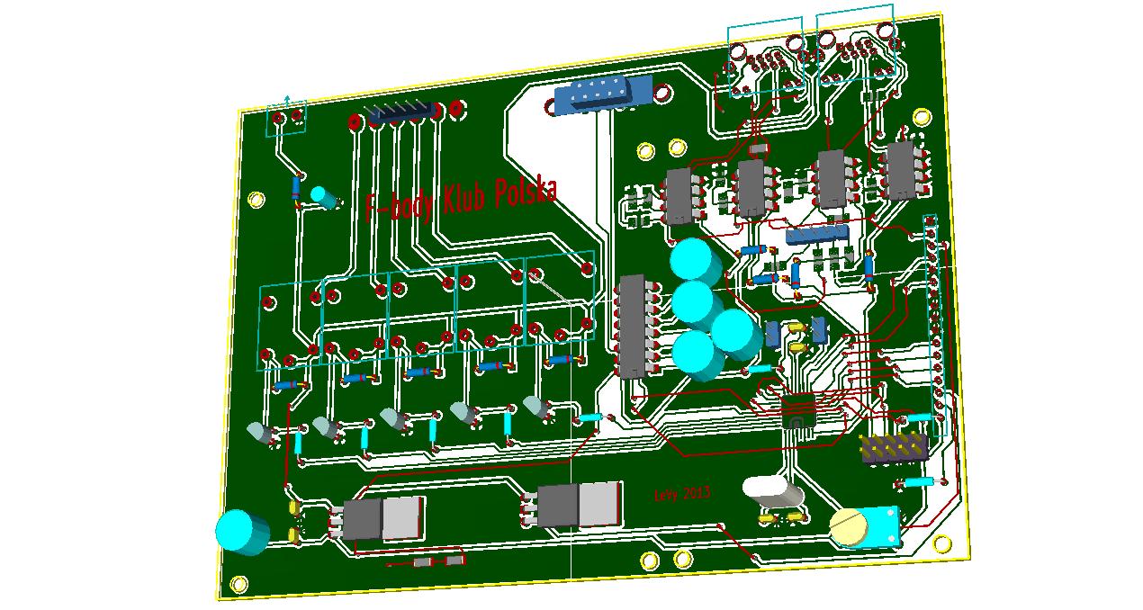
kicad_backup/plyta_glowna.jpg
