levykrak/cwiartka/rozne_pliki/obudowa-z53_1325.jpg

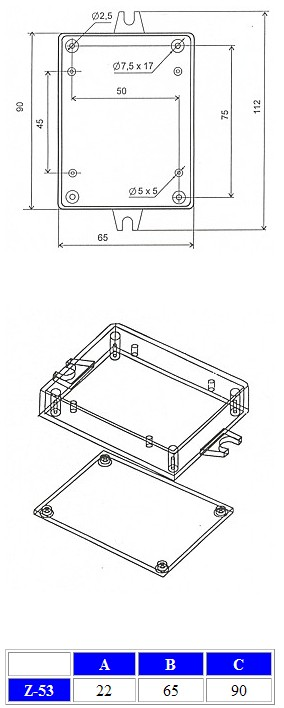
rozne_pliki/obudowa-z53_1325.jpg
