levykrak/cwiartka/rozne_pliki/schemat555.gif

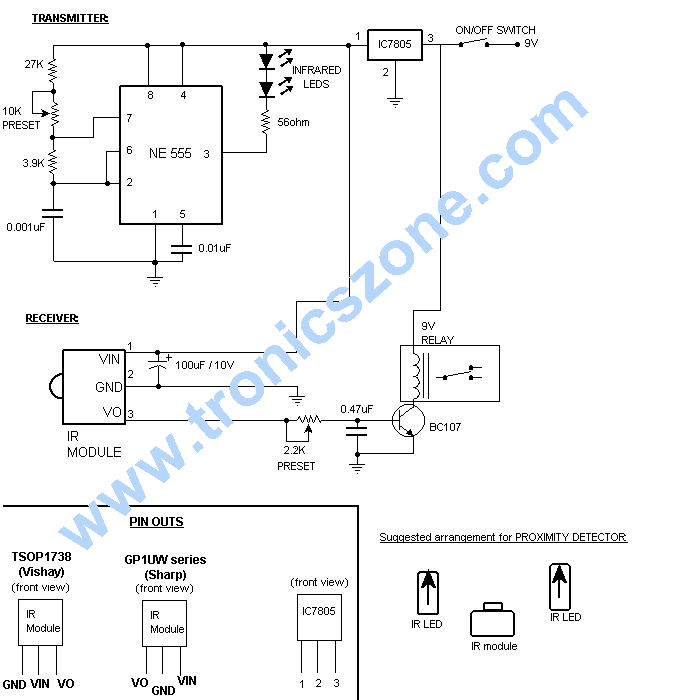
rozne_pliki/schemat555.gif
