levykrak/cwiartka/rozne_pliki/wypelnienie_25.JPG

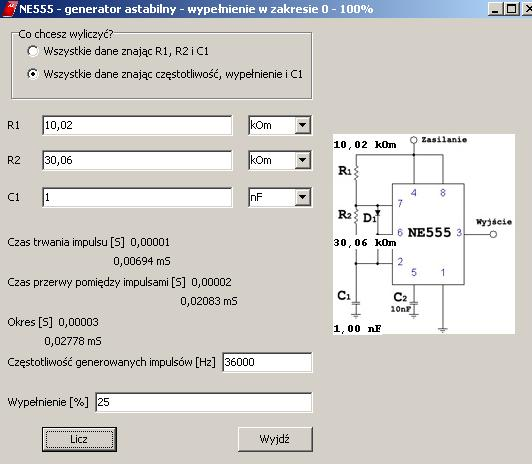
rozne_pliki/wypelnienie_25.JPG
