levykrak/cwiartka/3D/M1.STL

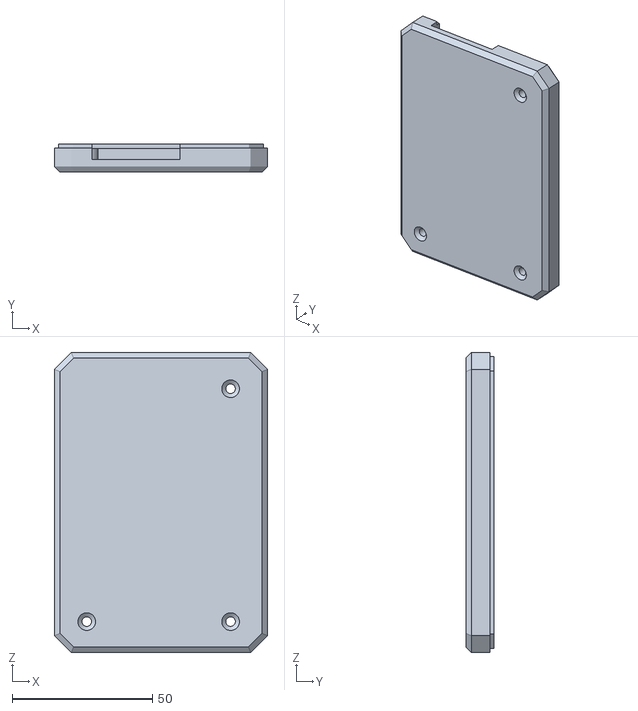
[picture p23: CAD file, 2019-05-13]
3D/M1.STL
76.0 x 10.1 x 107.0
