levykrak/cwiartka/kicad/plyta_glowna.step

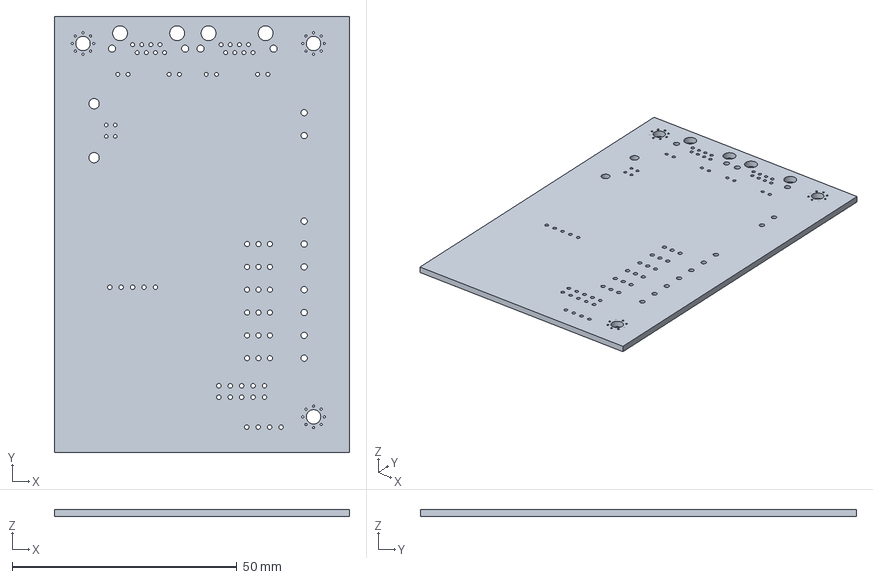
[picture p24: CAD file, 2019-05-13]
kicad/plyta_glowna.step
65.7 x 97.0 x 1.60 mm
C_1206 x 9
USB_B
RJHSE538X x 2
R_1206 x 27
TQFP-32_7x7mm_Pitch0.8mm
SSOP-28_5.3x10.2mm_Pitch0.65mm
SOIC-8-N x 4
