levykrak/cwiartka/3D/M2b_gora.STL

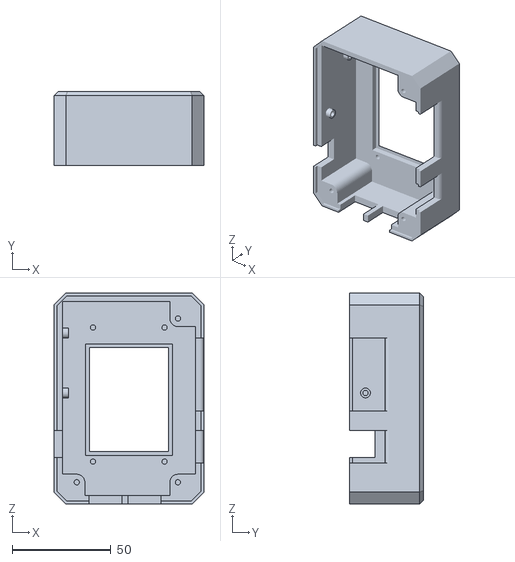
[picture p25: CAD file, 2019-05-13]
3D/M2b_gora.STL
76.0 x 37.5 x 107.0
