levykrak/cwiartka/(list of files, cad)

Other CAD files:
bascom/test.obj
bascom_KOPIA/cwiartka.obj
bascom/cwiartka.obj
bascom_KOPIA/cwiartka1.obj
3D/M2.STL
bascom/cwiartka1.obj
bascom_KOPIA/test.obj
front_wyswietlacz.CATPart
plyta_old/front_wyswietlacz.CATPart
