levykrak/cwiartka/front.pdf

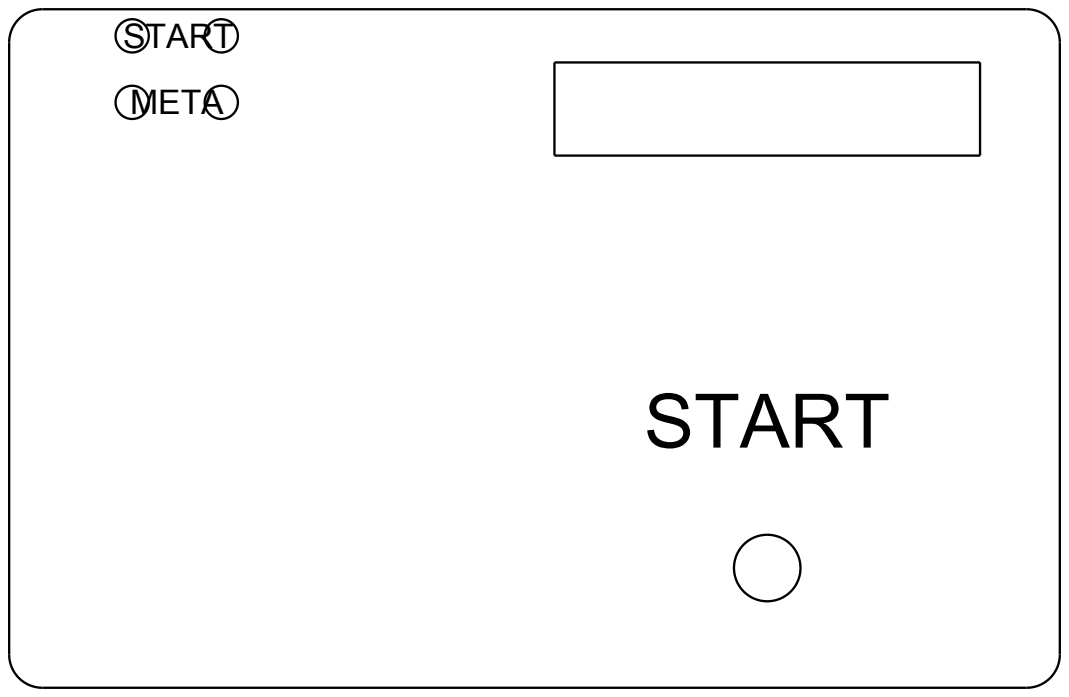
[picture p26: page 1]
START; META
