levykrak/cwiartka/kicad/schemat.pdf

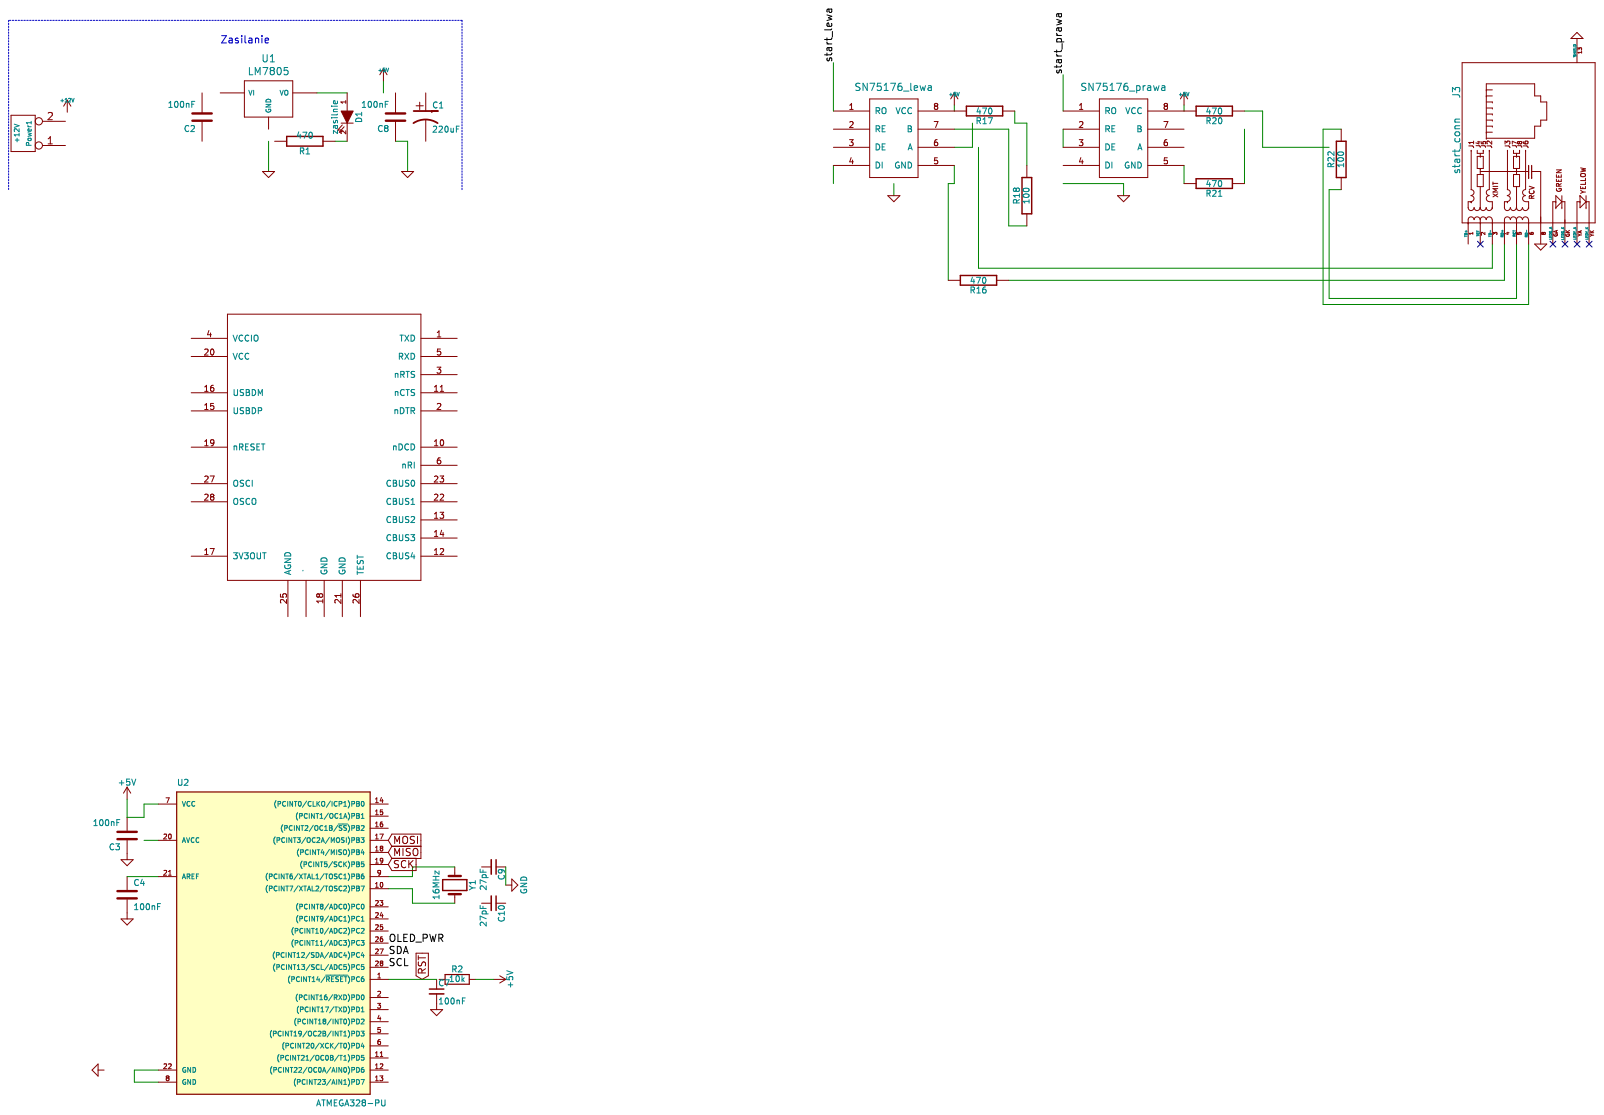
[picture p27: page 1]
