levykrak/cwiartka/(list of files, drawings)

Other design files:
brama_test.dsn
plyta_old/brama_test.dsn
