levykrak/cwiartka/plyta_old/plyta_glowna.kicad_pcb

## KiCad design plyta_old/plyta_glowna.kicad_pcb (2019-05-13, an earlier design)

Schematic: plyta_glowna.sch, Załącznik 4 – schemat sterownika

Parts:
C1: 220uF
C2, C6, C7, C8: 100nF
C3, C4: 27pF
C9: 100uF
C10, C11, C12, C13: 10uF
D1: zasilnie
D2, D3, D4, D5, D6, D7, D9, D10, D13, D15: DIODE
FB1: 10uH
IC1: ATMEGA8-MI-sterowanie; MLF32
J2: DB9
J3, J4: RJ45-TRANSFO
K1, K2, K3, K4, K5: PRZEKAZNIK1
P1: +12V
P2: ISP_sterowanie
P4: LCD 2x16
P5: CONN_6
P6: Ledy_kontrolne
Q1, Q2, Q3, Q4, Q5: BC337 lub BC548
R1, R9, R10, R12, R13, R15, R16, R17, R19, R20, R21, R23, R24: 470
R2: 10k
R3: 10
R4, R5, R6, R8: 4,7k
R7: 4,7
R11, R14, R18, R22: 100
RV1: 10k
SW1: Start
SW2: KJS
U1: LM7805
U2, U6: SN75176_lewa
U3, U7: SN75176_prawa
U4: MAX232
U5: LM7805_wyswietlacz
X1: 16MHz

Connections:
1: IC1.9 ((T1)PD5), R8.1
2: IC1.10 ((AIN0)PD6), R7.1
3: IC1.11 ((AIN1)PD7), R6.1
4: IC1.12 ((ICP)PB0), R5.1
5: IC1.13 ((OC1A)PB1), R4.1
+5P: P4.15, U5.VO
+5V: C8.2, C9.1, C12.2, D1.1 (A), FB1.1, IC1.4 (VCC), IC1.6 (VCC), P2.2, P4.2, P6.5, R2.1, R10.2, R12.2, R17.2, R20.2, RV1.1, U1.VO, U2.8 (VCC), U3.8 (VCC), U4.16 (VCC), U6.8 (VCC), U7.8 (VCC)
+12V: D2.1 (A), D3.2 (K), D4.2 (K), D5.2 (K), D6.2 (K), D7.2 (K), J3.1 (TD+), J4.1 (TD+), K1.1, K1.5, K2.1, K2.5, K3.1, K3.5, K4.1, K4.5, K5.1, K5.5, P1.2 (PM)
GND: C1.2, C2.1, C3.2, C4.2, C6.2, C7.2, C8.1, C9.2, C13.1, IC1.3 (GND), IC1.5 (GND), IC1.21 (AGND), J2.5, J3.8, J3.13 (SHIELD), J4.8, J4.13 (SHIELD), P1.1, P2.4, P2.6, P2.8, P2.10, P4.1, P4.5, P4.7, P4.8, P4.9, P4.10, P5.6, Q1.E, Q2.E, Q3.E, Q4.E, Q5.E, R1.2, R3.1, R9.2, R13.2, R16.2, R21.2, RV1.3, SW1.2, SW2.2, U1.GND, U2.2 (RE), U2.3 (DE), U2.4 (DI), U2.5 (GND), U3.2 (RE), U3.3 (DE), U3.4 (DI), U3.5 (GND), U4.15 (GND), U5.GND, U6.2 (RE), U6.3 (DE), U6.4 (DI), U6.5 (GND), U7.2 (RE), U7.3 (DE), U7.4 (DI), U7.5 (GND)
unnamed: J4.3 (TD-), R10.1, R11.2, U2.6 (A)
unnamed: D15.1 (A), R24.2, U3.1 (RO)
unnamed: Q1.B, R4.2
unnamed: D3.1 (A), K1.2, Q1.C
unnamed: IC1.22 (ADC7), SW2.1
unnamed: C11.1, U4.4 (C2+)
unnamed: C11.2, U4.5 (C2-)
unnamed: C10.1, U4.1 (C1+)
unnamed: C10.2, U4.3 (C1-)
unnamed: C12.1, U4.2 (V+)
unnamed: J2.3, U4.13 (R1IN)
unnamed: J2.4, J2.6
unnamed: J2.7, J2.8
unnamed: C13.2, U4.6 (V-)
unnamed: K4.4, P5.2
unnamed: K1.4, P5.5
unnamed: K5.4, P5.1
unnamed: J4.4 (RD+), R9.1, R11.1, U2.7 (B)
unnamed: Q4.B, R7.2
unnamed: D6.1 (A), K4.2, Q4.C
unnamed: K2.4, P5.4
unnamed: Q2.B, R5.2
unnamed: D4.1 (A), K2.2, Q2.C
unnamed: D7.1 (A), K5.2, Q5.C
unnamed: Q5.B, R8.2
unnamed: K3.4, P5.3
unnamed: D5.1 (A), K3.2, Q3.C
unnamed: Q3.B, R6.2
unnamed: IC1.23 ((ADC0)PC0), P4.4
unnamed: IC1.24 ((ADC1)PC1), P4.6
unnamed: IC1.15 ((MOSI/OC2)PB3), P2.1
unnamed: IC1.16 ((MISO)PB4), P2.9
unnamed: IC1.17 ((SCK)PB5), P2.7
unnamed: IC1.19 (ADC6), SW1.1
unnamed: C3.1, IC1.7 (PB6(XTAL1/TOSC1)), X1.1
unnamed: IC1.31 ((TXD)PD1), U4.11 (T1IN)
unnamed: IC1.25 ((ADC2)PC2), P4.11
unnamed: IC1.27 ((ADC4/SDA)PC4), P4.13
unnamed: IC1.30 ((RXD)PD0), U4.12 (R1OUT)
unnamed: P4.3, RV1.2
unnamed: IC1.26 ((ADC3)PC3), P4.12
unnamed: IC1.28 ((ADC5/SCL)PC5), P4.14
unnamed: P4.16, R3.2
unnamed: J2.2, U4.14 (T1OUT)
unnamed: C1.1, C2.2, D2.2 (K), U1.VI, U5.VI
unnamed: C4.1, IC1.8 (PB7(XTAL2/TOSC2)), X1.2
unnamed: C6.1, IC1.20 (AREF)
unnamed: D1.2 (K), R1.1
unnamed: C7.1, FB1.2, IC1.18 (AVCC)
unnamed: IC1.29 (PC6(~RESET~)), P2.5, R2.2
unnamed: J4.5 (RCT), R12.1, R14.1, U3.6 (A)
unnamed: D10.2 (K), D15.2 (K), IC1.1 ((INT1)PD3)
unnamed: J4.6 (RD-), R13.1, R14.2, U3.7 (B)
unnamed: D9.1 (A), R15.2, U6.1 (RO)
unnamed: D9.2 (K), D13.2 (K), IC1.32 ((INT0)PD2)
unnamed: D13.1 (A), R23.2, U2.1 (RO)
unnamed: J3.5 (RCT), R20.1, R22.1, U7.6 (A)
unnamed: J3.4 (RD+), R16.1, R18.1, U6.7 (B)
unnamed: J3.6 (RD-), R21.1, R22.2, U7.7 (B)
unnamed: D10.1 (A), R19.2, U7.1 (RO)
unnamed: J3.3 (TD-), R17.1, R18.2, U6.6 (A)
lewa_meta: P6.3, R15.1
lewa_start: P6.1, R23.1
prawa_meta: P6.4, R19.1
prawa_start: P6.2, R24.1

Notes on the sheet:
ISP
Zasilanie
Wyswietlacz

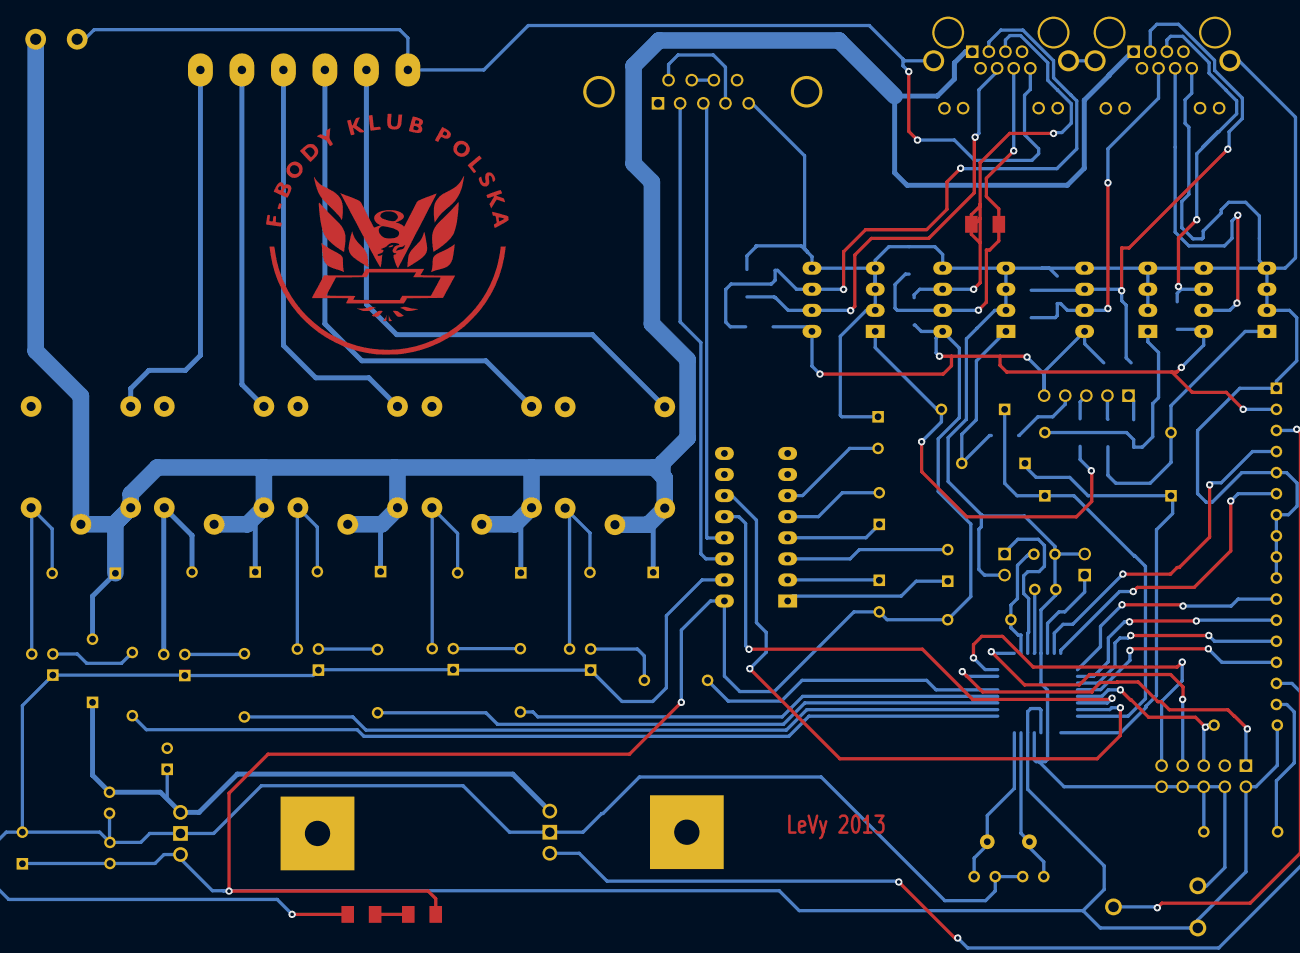
[picture p42: board plyta_old/plyta_glowna.kicad_pcb from above]

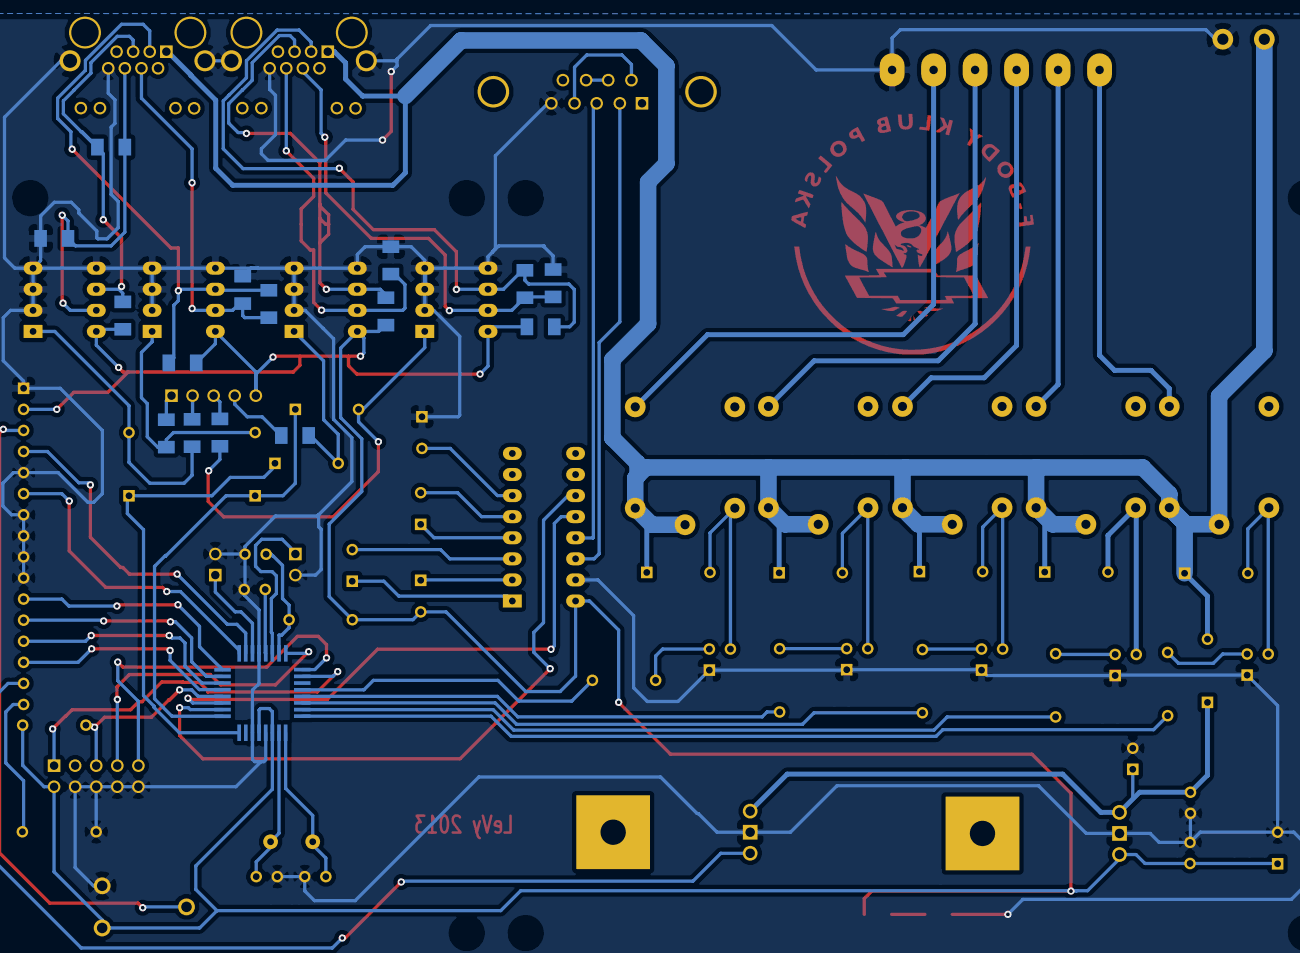
[picture p43: board plyta_old/plyta_glowna.kicad_pcb from below]

Board: 2 copper layers, 79 parts (16 on the bottom side), 74 nets.

Other parts of the board:
VAL: logo_fbody_plyta
