levykrak/cwiartka/generator/generator.kicad_pcb

## KiCad design generator/generator.kicad_pcb (2019-05-13)

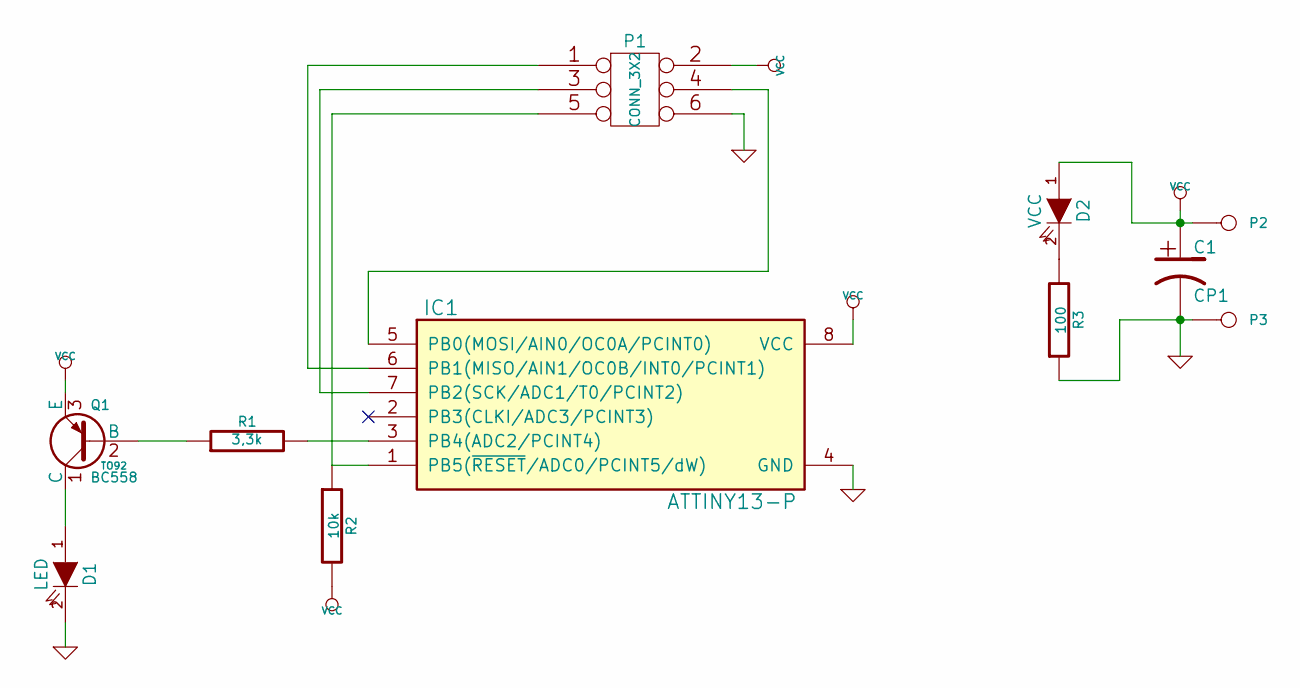
[picture p44: schematic generator.sch]

Parts:
C1: CP1
D1: LED
D2: VCC
IC1: ATTINY13-P; DIP8
P1: CONN_3X2
P2, P3: CONN_1
Q1: BC558; TO92
R1: 3,3k
R2: 10k
R3: 100

Connections:
GND: C1.2, D1.2 (K), IC1.4 (GND), P1.6, P3.1, R3.1
unnamed: IC1.1 (PB5(~RESET~/ADC0/PCINT5/dW)), P1.5, R2.1
unnamed: D1.1 (A), Q1.1 (C)
unnamed: IC1.3 (PB4(ADC2/PCINT4)), R1.2
unnamed: Q1.2 (B), R1.1
unnamed: IC1.5 (PB0(MOSI/AIN0/OC0A/PCINT0)), P1.4
unnamed: D2.2 (K), R3.2
unnamed: IC1.7 (PB2(SCK/ADC1/T0/PCINT2)), P1.3
unnamed: IC1.6 (PB1(MISO/AIN1/OC0B/INT0/PCINT1)), P1.1
VCC: C1.1, D2.1 (A), IC1.8 (VCC), P1.2, P2.1, Q1.3 (E), R2.2

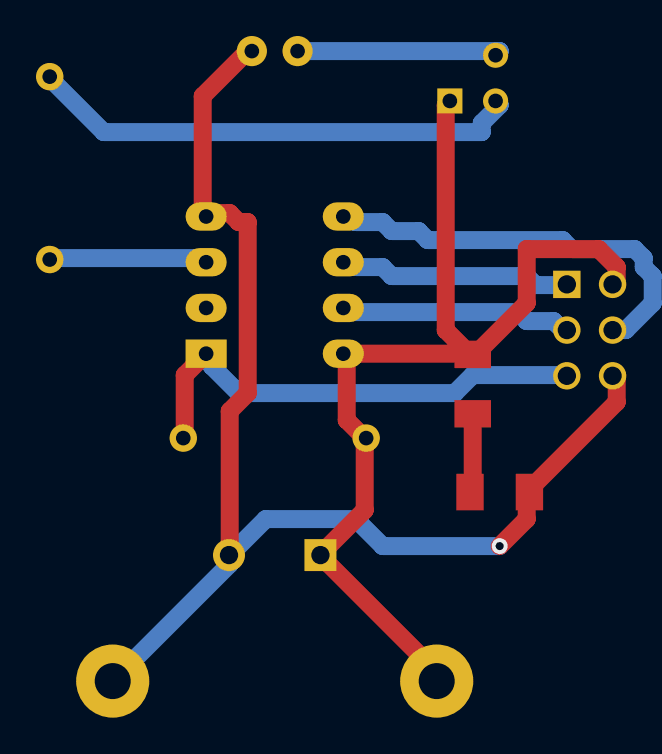
[picture p45: board generator.kicad_pcb from above]

Board: 2 copper layers, 11 parts (0 on the bottom side), 10 nets.
