levykrak/cwiartka/brama.sch

## KiCad design brama.sch (2019-05-13)


Parts:
C1: 220uF
C2, C8: 100nF
C9: 100uF
D2: Fotodioda_lewa
D3: Fotodioda_prawa
D4: LEDlewa
D5: LEDprawa
J3: RJ45-TRANSFO
R4, R5: 1,5M
R6, R7, R12: 470
R13: 100
RV2: np100k_lewa
RV3: np100k
U1: LM7805
U2: SN75176_lewa
U3: TL072
U4: SN75176_prawa
U5: ULN2803A
r14: 100

Connections:
+5V: C8.2, C9.1, J3.YA (LEDY_A), R4.2, R5.2, R6.1, R7.1, RV2.1, RV3.1, U1.VO, U2.3 (DE), U2.8 (VCC), U3.8 (V+), U4.3 (DE), U4.8 (VCC), U5.10 (UCC)
GND: C1.2, C2.1, C8.1, C9.2, D2.1 (A), D3.1 (A), J3.8, J3.13 (SHIELD), R12.2, RV2.3, RV3.3, U1.GND, U2.1 (RO), U2.2 (RE), U2.5 (GND), U3.4 (V-), U4.1 (RO), U4.2 (RE), U4.5 (GND), U5.9 (GND)
unnamed: C1.1, C2.2, J3.1 (TD+), U1.VI
unnamed: D2.2 (K), R4.1, U3.3 (+)
unnamed: D3.2 (K), R5.1, U3.5 (+)
unnamed: D4.1 (A), R6.2
unnamed: D4.2 (K), U2.4 (DI), U5.18 (O1)
unnamed: D5.1 (A), R7.2
unnamed: D5.2 (K), U4.4 (DI), U5.17 (O2)
unnamed: J3.3 (TD-), R13.2, U2.6 (A)
unnamed: J3.4 (RD+), R13.1, U2.7 (B)
unnamed: J3.5 (RCT), U4.6 (A), r14.1
unnamed: J3.6 (RD-), U4.7 (B), r14.2
unnamed: J3.YK (LEDY_K), R12.1
unnamed: RV2.2, U3.2 (-)
unnamed: RV3.2, U3.6 (-)
unnamed: U3.1, U5.1 (I1)
unnamed: U3.7, U5.2 (I2)
