levykrak/cwiartka/brama_IRDA.sch

## KiCad design brama_IRDA.sch (2019-05-13)

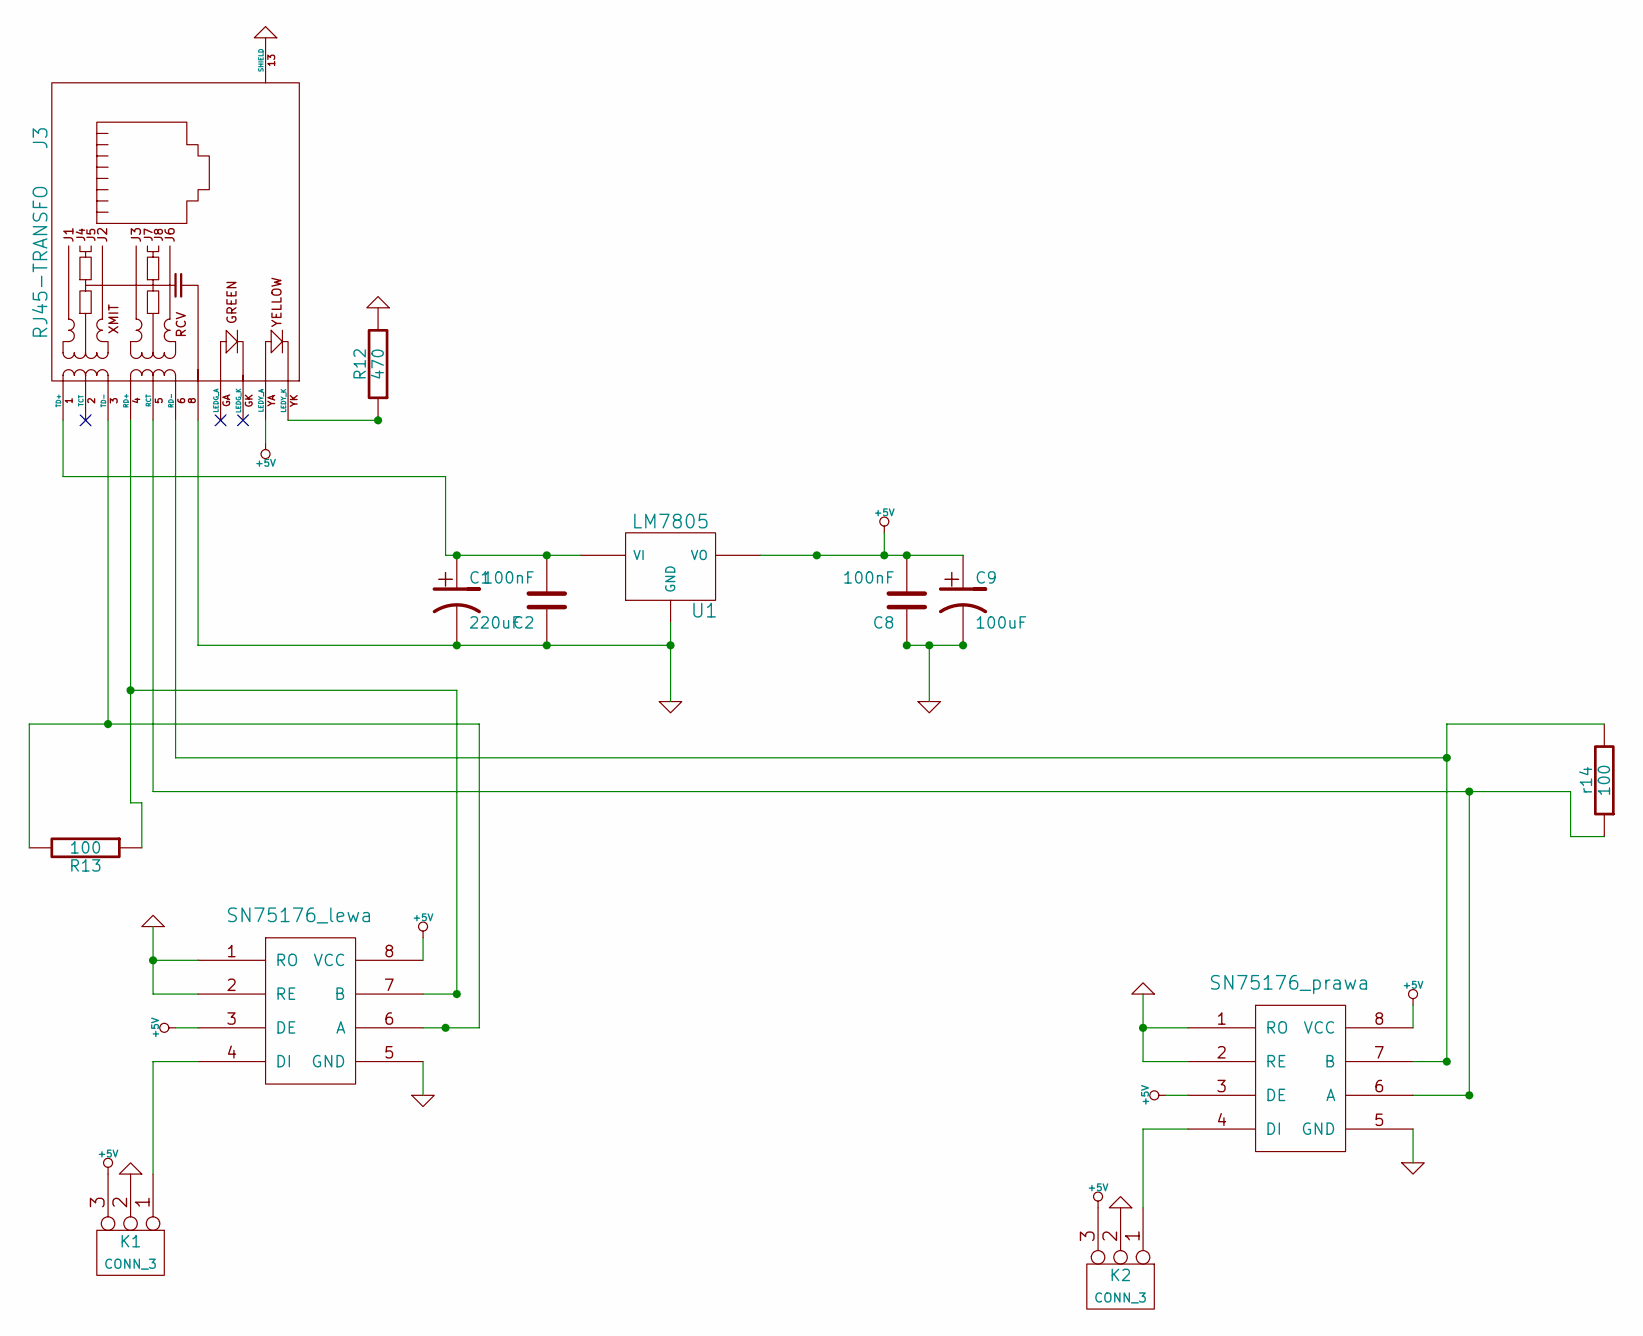
[picture p52: schematic brama_IRDA.sch]

Parts:
C1: 220uF
C2, C8: 100nF
C9: 100uF
J3: RJ45-TRANSFO
K1, K2: CONN_3
R12: 470
R13: 100
U1: LM7805
U2: SN75176_lewa
U4: SN75176_prawa
r14: 100

Connections:
+5V: C8.2, C9.1, J3.YA (LEDY_A), K1.3, K2.3, U1.VO, U2.3 (DE), U2.8 (VCC), U4.3 (DE), U4.8 (VCC)
GND: C1.2, C2.1, C8.1, C9.2, J3.8, J3.13 (SHIELD), K1.2 (PM), K2.2 (PM), R12.2, U1.GND, U2.1 (RO), U2.2 (RE), U2.5 (GND), U4.1 (RO), U4.2 (RE), U4.5 (GND)
unnamed: C1.1, C2.2, J3.1 (TD+), U1.VI
unnamed: J3.3 (TD-), R13.2, U2.6 (A)
unnamed: J3.4 (RD+), R13.1, U2.7 (B)
unnamed: J3.5 (RCT), U4.6 (A), r14.1
unnamed: J3.6 (RD-), U4.7 (B), r14.2
unnamed: J3.YK (LEDY_K), R12.1
unnamed: K1.1, U2.4 (DI)
unnamed: K2.1, U4.4 (DI)
