levykrak/cwiartka/generator/generator.sch

## KiCad design generator/generator.sch (2019-05-13)


Parts:
C1: CP1
D1: LED
D2: VCC
IC1: ATTINY13-P; DIP8
P1: CONN_3X2
P2, P3: CONN_1
Q1: BC558; TO92
R1: 3,3k
R2: 10k
R3: 100

Connections:
GND: C1.2, D1.2 (K), IC1.4 (GND), P1.6, P3.1, R3.1
unnamed: D1.1 (A), Q1.1 (C)
unnamed: D2.2 (K), R3.2
unnamed: IC1.1 (PB5(~RESET~/ADC0/PCINT5/dW)), P1.5, R2.1
unnamed: IC1.3 (PB4(ADC2/PCINT4)), R1.2
unnamed: IC1.5 (PB0(MOSI/AIN0/OC0A/PCINT0)), P1.4
unnamed: IC1.6 (PB1(MISO/AIN1/OC0B/INT0/PCINT1)), P1.1
unnamed: IC1.7 (PB2(SCK/ADC1/T0/PCINT2)), P1.3
unnamed: Q1.2 (B), R1.1
VCC: C1.1, D2.1 (A), IC1.8 (VCC), P1.2, P2.1, Q1.3 (E), R2.2
