levykrak/cwiartka/kicad_backup/plyta_glowna.sch

## KiCad design kicad_backup/plyta_glowna.sch (2019-05-13)

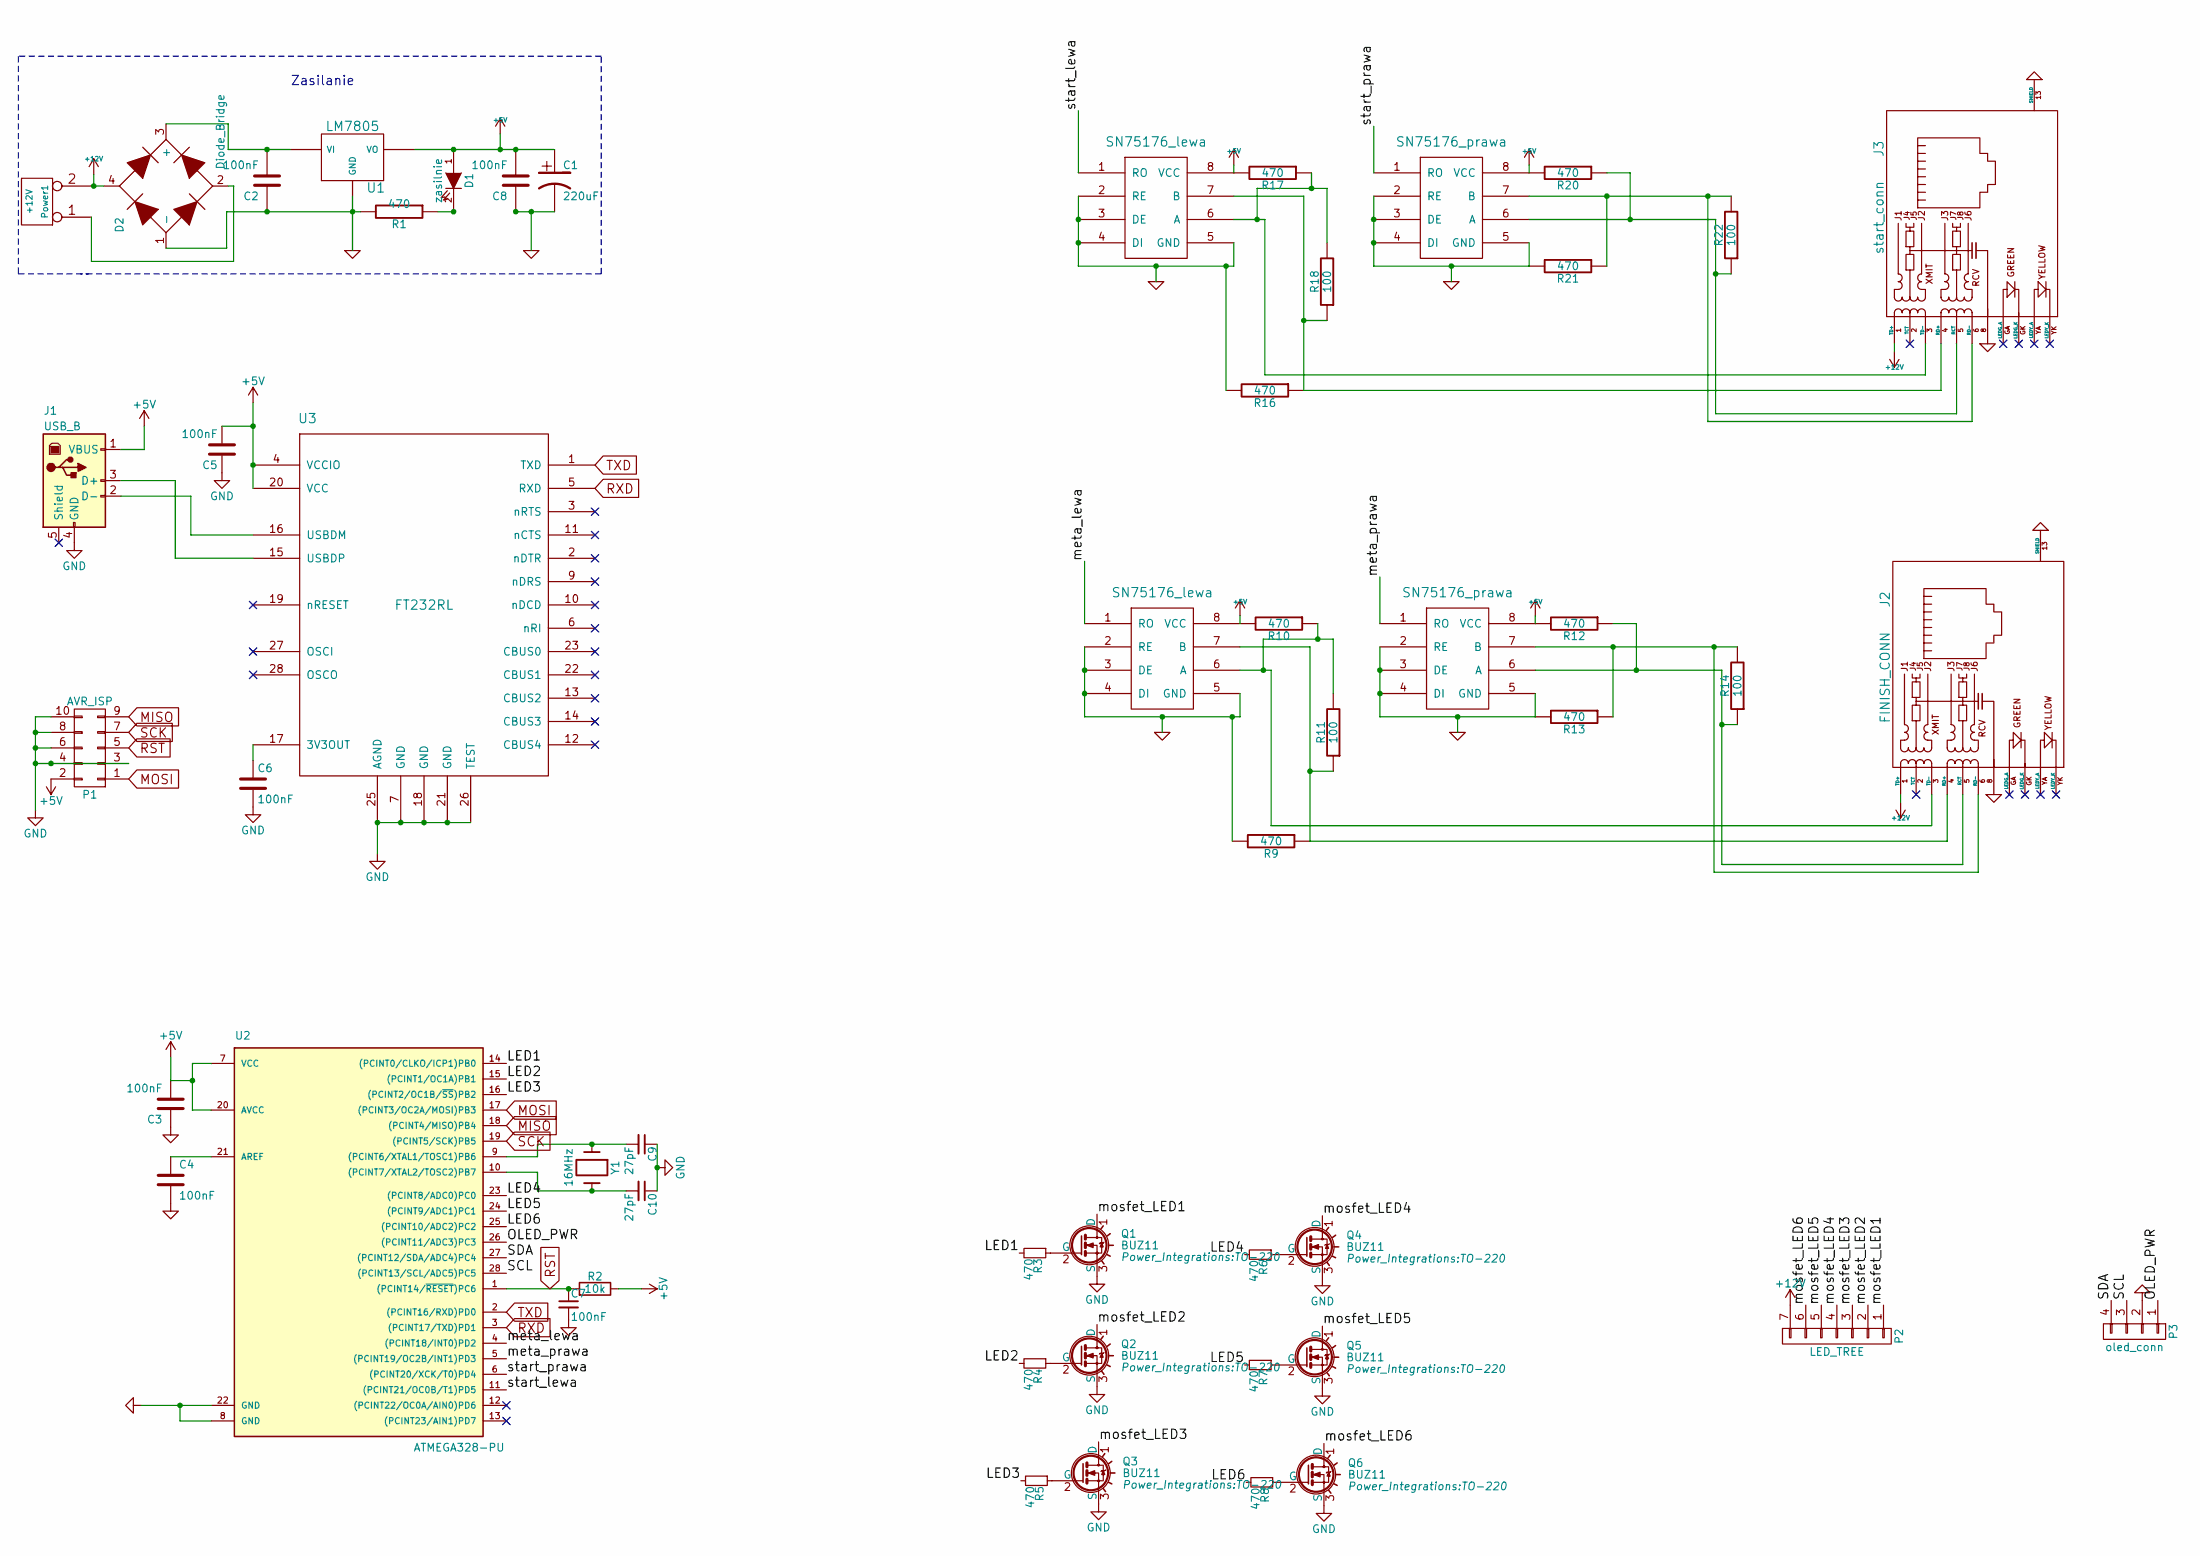
[picture p54: schematic plyta_glowna.sch]

Parts:
C1: 220uF; CP_Elec_10x10.5
C2, C3, C4, C5, C6, C7, C8: 100nF; C_1206
C9, C10: 27pF; C_1206
D1: zasilnie; LED_1206
D2: Diode_Bridge; DB151
J1: USB_B
J2: FINISH_CONN
J3: start_conn
P1: AVR_ISP; Pin_Header_Straight_2x05
P2: LED_TREE; PhoenixContact_MC-GF_07x5.08mm_Angled_ThreadedFlange
P3: oled_conn; Pin_Header_Straight_1x04_Pitch1.27mm
Power1: +12V; Molex_KK-6410-02_02x2.54mm_Straight
Q1, Q2, Q3, Q4, Q5, Q6: BUZ11; TO-220
R1, R3, R4, R5, R6, R7, R8, R9, R10, R12, R13, R16, R17, R20, R21: 470; R_1206
R2: 10k; R_1206
R11, R14, R18, R22: 100; R_1206
U1: LM7805
U2: ATMEGA328-PU; DIL28
U3: FT232RL; SSOP-28_5.3x10.2mm_Pitch0.65mm
U4, U6: SN75176_lewa; SOIC-8-N
U5, U7: SN75176_prawa; SOIC-8-N
Y1: 16MHz; Crystal_SMD_HC49-SD

Connections:
+5V: C1.1, C3.2, C5.2, C8.2, D1.1 (A), J1.1 (VBUS), P1.2, R2.1, R10.2, R12.2, R17.2, R20.2, U1.VO, U2.7 (VCC), U2.20 (AVCC), U3.4 (VCCIO), U3.20 (VCC), U4.8 (VCC), U5.8 (VCC), U6.8 (VCC), U7.8 (VCC)
+12V: D2.4, J2.1 (TD+), J3.1 (TD+), P2.7, Power1.2 (PM)
GND: C1.2, C2.1, C3.1, C4.2, C5.1, C6.2, C7.2, C8.1, C9.1, C10.1, D2.1 (-), J1.4 (GND), J2.8, J2.13 (SHIELD), J3.8, J3.13 (SHIELD), P1.3, P1.4, P1.6, P1.8, P1.10, P3.2, Q1.3 (S), Q2.3 (S), Q3.3 (S), Q4.3 (S), Q5.3 (S), Q6.3 (S), R1.2, R9.2, R13.2, R16.2, R21.2, U1.GND, U2.8 (GND), U2.22 (GND), U3.7 (GND), U3.18 (GND), U3.21 (GND), U3.25 (AGND), U3.26 (TEST), U4.2 (RE), U4.3 (DE), U4.4 (DI), U4.5 (GND), U5.2 (RE), U5.3 (DE), U5.4 (DI), U5.5 (GND), U6.2 (RE), U6.3 (DE), U6.4 (DI), U6.5 (GND), U7.2 (RE), U7.3 (DE), U7.4 (DI), U7.5 (GND)
LED1: R3.2, U2.14 ((PCINT0/CLKO/ICP1)PB0)
LED2: R4.2, U2.15 ((PCINT1/OC1A)PB1)
LED3: R5.2, U2.16 ((PCINT2/OC1B/~SS~)PB2)
LED4: R6.2, U2.23 ((PCINT8/ADC0)PC0)
LED5: R7.2, U2.24 ((PCINT9/ADC1)PC1)
LED6: R8.2, U2.25 ((PCINT10/ADC2)PC2)
MISO: P1.9, U2.18 ((PCINT4/MISO)PB4)
MOSI: P1.1, U2.17 ((PCINT3/OC2A/MOSI)PB3)
unnamed: C2.2, D2.3 (+), U1.VI
unnamed: C4.1, U2.21 (AREF)
unnamed: C6.1, U3.17 (3V3OUT)
unnamed: C9.2, U2.9 ((PCINT6/XTAL1/TOSC1)PB6), Y1.1
unnamed: C10.2, U2.10 ((PCINT7/XTAL2/TOSC2)PB7), Y1.2
unnamed: D1.2 (K), R1.1
unnamed: D2.2, Power1.1
unnamed: J1.2 (D-), U3.16 (USBDM)
unnamed: J1.3 (D+), U3.15 (USBDP)
unnamed: J2.3 (TD-), R10.1, R11.2, U4.6 (A)
unnamed: J2.4 (RD+), R9.1, R11.1, U4.7 (B)
unnamed: J2.5 (RCT), R12.1, R14.1, U5.6 (A)
unnamed: J2.6 (RD-), R13.1, R14.2, U5.7 (B)
unnamed: J3.3 (TD-), R17.1, R18.2, U6.6 (A)
unnamed: J3.4 (RD+), R16.1, R18.1, U6.7 (B)
unnamed: J3.5 (RCT), R20.1, R22.1, U7.6 (A)
unnamed: J3.6 (RD-), R21.1, R22.2, U7.7 (B)
unnamed: Q1.2 (G), R3.1
unnamed: Q2.2 (G), R4.1
unnamed: Q3.2 (G), R5.1
unnamed: Q4.2 (G), R6.1
unnamed: Q5.2 (G), R7.1
unnamed: Q6.2 (G), R8.1
OLED_PWR: P3.1, U2.26 ((PCINT11/ADC3)PC3)
RST: C7.1, P1.5, R2.2, U2.1 ((PCINT14/~RESET~)PC6)
RXD: U2.3 ((PCINT17/TXD)PD1), U3.5 (RXD)
SCK: P1.7, U2.19 ((PCINT5/SCK)PB5)
SCL: P3.3, U2.28 ((PCINT13/SCL/ADC5)PC5)
SDA: P3.4, U2.27 ((PCINT12/SDA/ADC4)PC4)
TXD: U2.2 ((PCINT16/RXD)PD0), U3.1 (TXD)
meta_lewa: U2.4 ((PCINT18/INT0)PD2), U4.1 (RO)
meta_prawa: U2.5 ((PCINT19/OC2B/INT1)PD3), U5.1 (RO)
mosfet_LED1: P2.1, Q1.1 (D)
mosfet_LED2: P2.2, Q2.1 (D)
mosfet_LED3: P2.3, Q3.1 (D)
mosfet_LED4: P2.4, Q4.1 (D)
mosfet_LED5: P2.5, Q5.1 (D)
mosfet_LED6: P2.6, Q6.1 (D)
start_lewa: U2.11 ((PCINT21/OC0B/T1)PD5), U6.1 (RO)
start_prawa: U2.6 ((PCINT20/XCK/T0)PD4), U7.1 (RO)

Notes on the sheet:
Zasilanie
