levykrak/cwiartka/plyta_old/plyta_glowna.sch

## KiCad design plyta_old/plyta_glowna.sch (2019-05-13, an earlier design)

Schematic: plyta_glowna.sch

Parts:
C1: 220uF
C2, C6, C7, C8: 100nF
C3, C4: 27pF
C9: 100uF
C10, C11, C12, C13: 10uF
D1: zasilnie
D2, D3, D4, D5, D6, D7, D9, D10, D13, D15: DIODE
FB1: 10uH
IC1: ATMEGA8-MI-sterowanie; MLF32
J2: DB9
J3, J4: RJ45-TRANSFO
K1, K2, K3, K4, K5: PRZEKAZNIK1
P1: +12V
P2: ISP_sterowanie
P4: LCD 2x16
P5: CONN_6
P6: Ledy_kontrolne
Q1, Q2, Q3, Q4, Q5: BC337 lub BC548
R1, R9, R10, R12, R13, R15, R16, R17, R19, R20, R21, R23, R24: 470
R2: 10k
R3: 10
R4, R5, R6, R8: 4,7k
R7: 4,7
R11, R14, R18, R22: 100
RV1: 10k
SW1: Start
SW2: KJS
U1: LM7805
U2, U6: SN75176_lewa
U3, U7: SN75176_prawa
U4: MAX232
U5: LM7805_wyswietlacz
X1: 16MHz

Notes on the sheet:
ISP
Zasilanie
Wyswietlacz
